anatolbricoham/bricohams-sdr/docs/esquemas/02_gpio_pi5.png

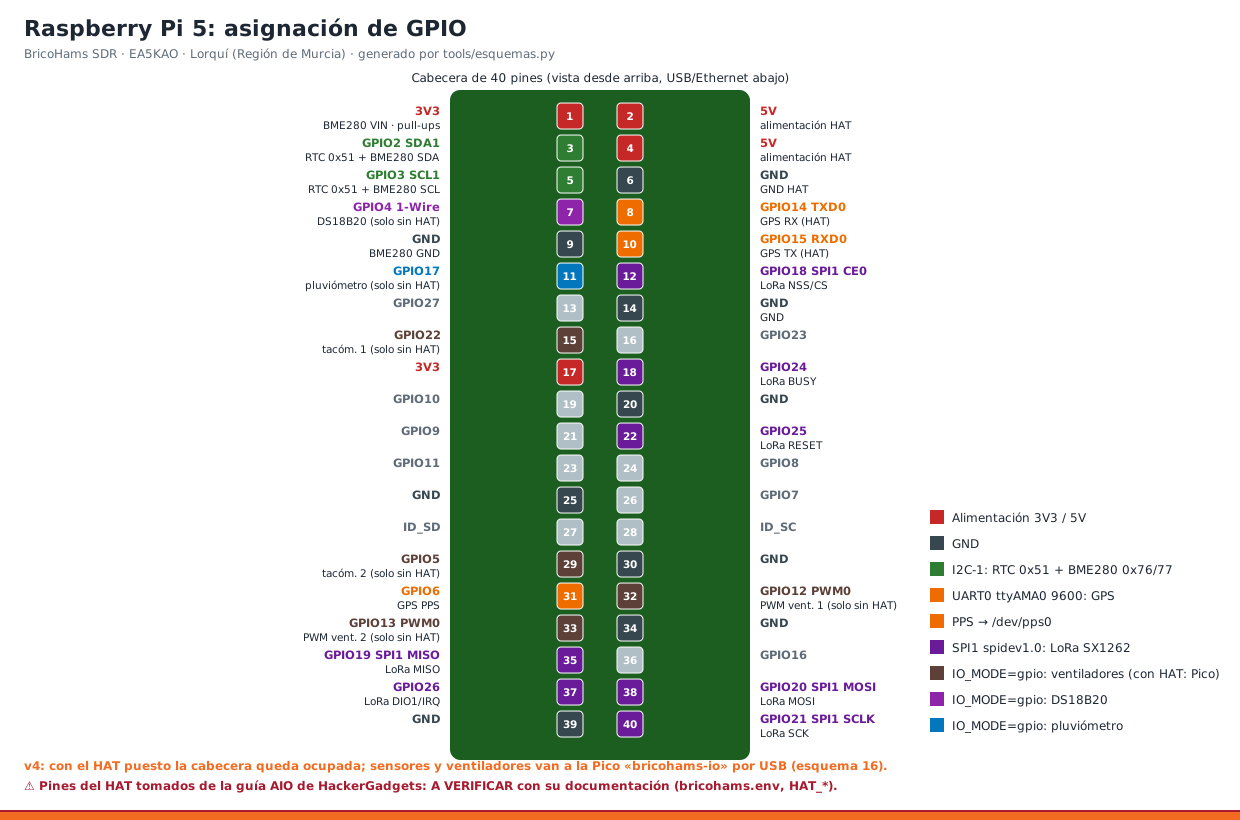
docs/esquemas/02_gpio_pi5.png
