anatolbricoham/bricohams-sdr/docs/esquemas/04_rf_antenas_alimentacion.png

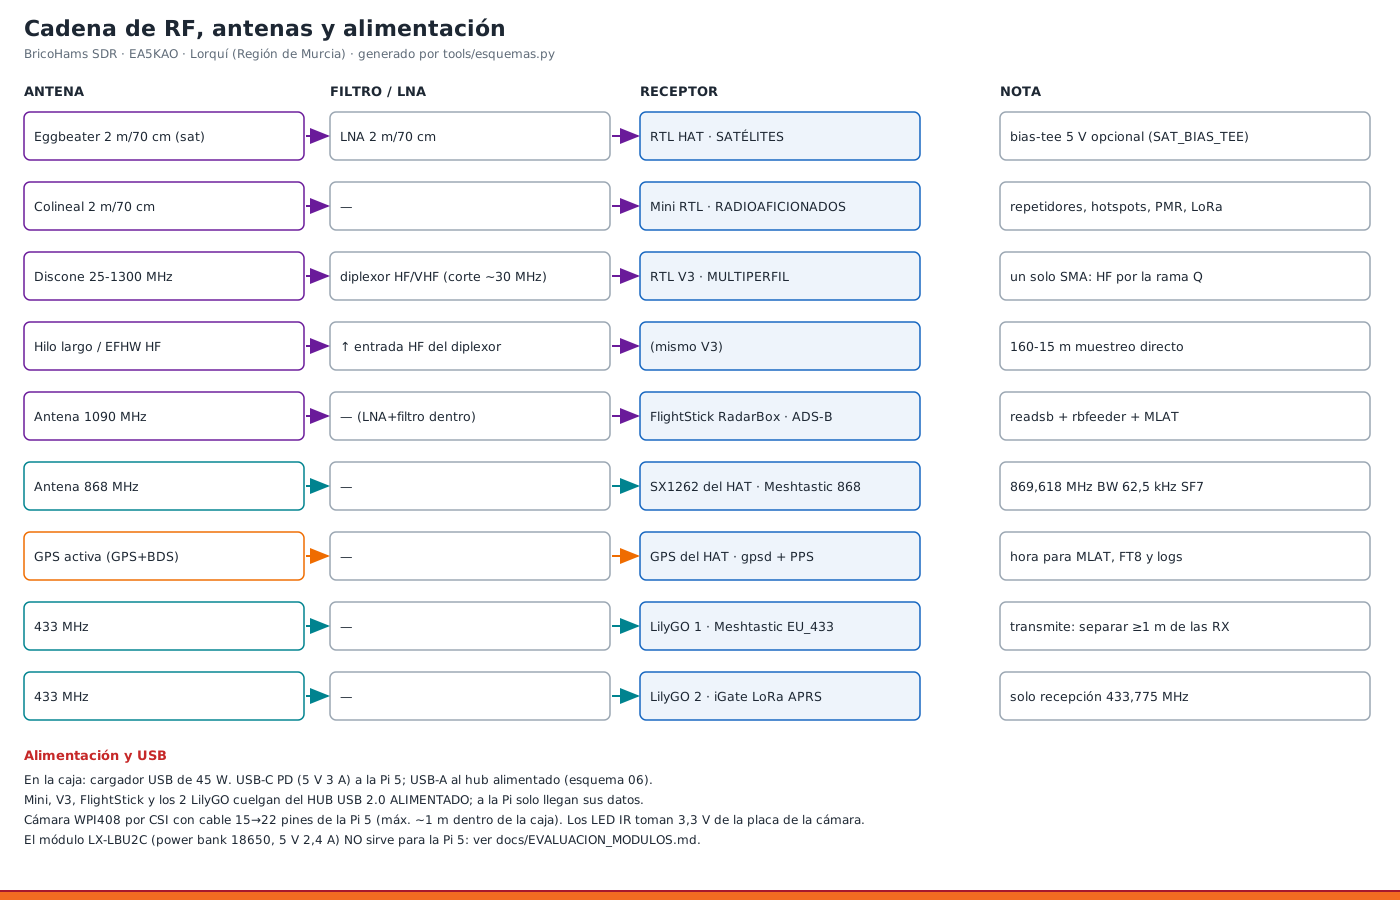
docs/esquemas/04_rf_antenas_alimentacion.png
