anatolbricoham/bricohams-sdr/docs/esquemas/05_red_puertos.png

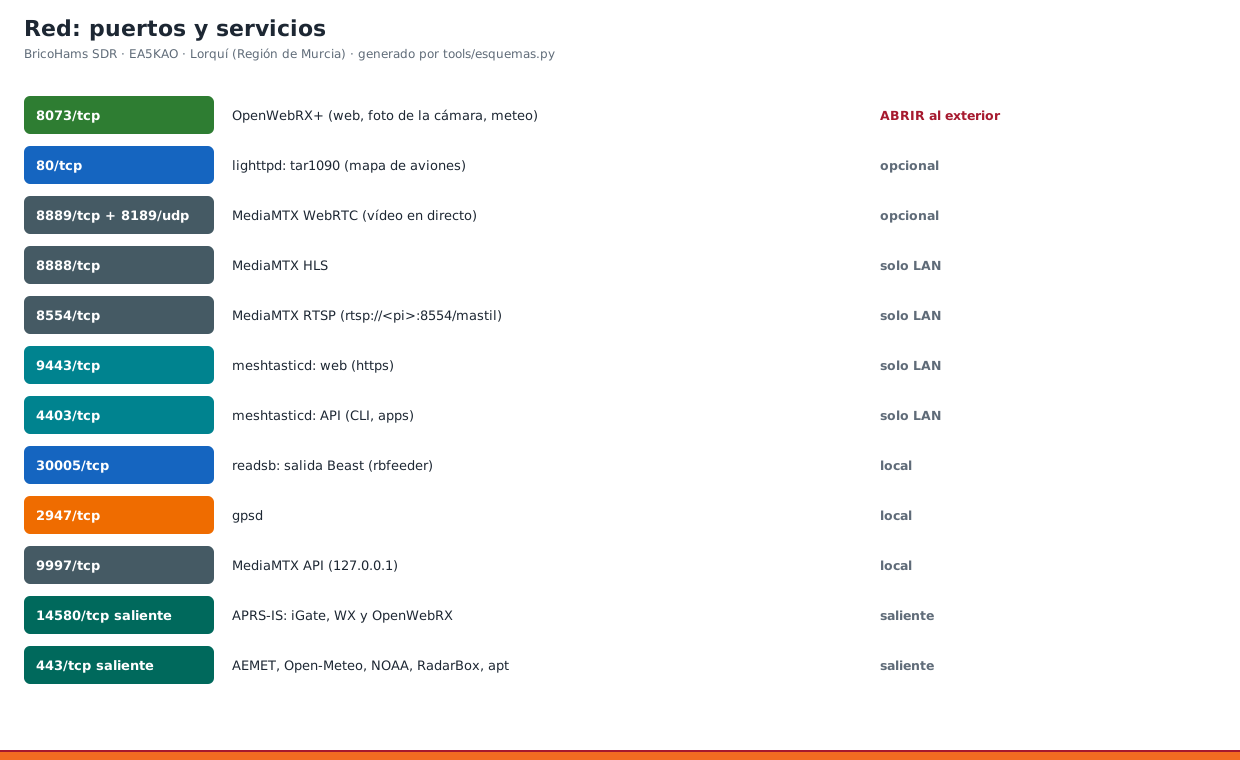
docs/esquemas/05_red_puertos.png
