anatolbricoham/bricohams-sdr/docs/esquemas/09_discones.png

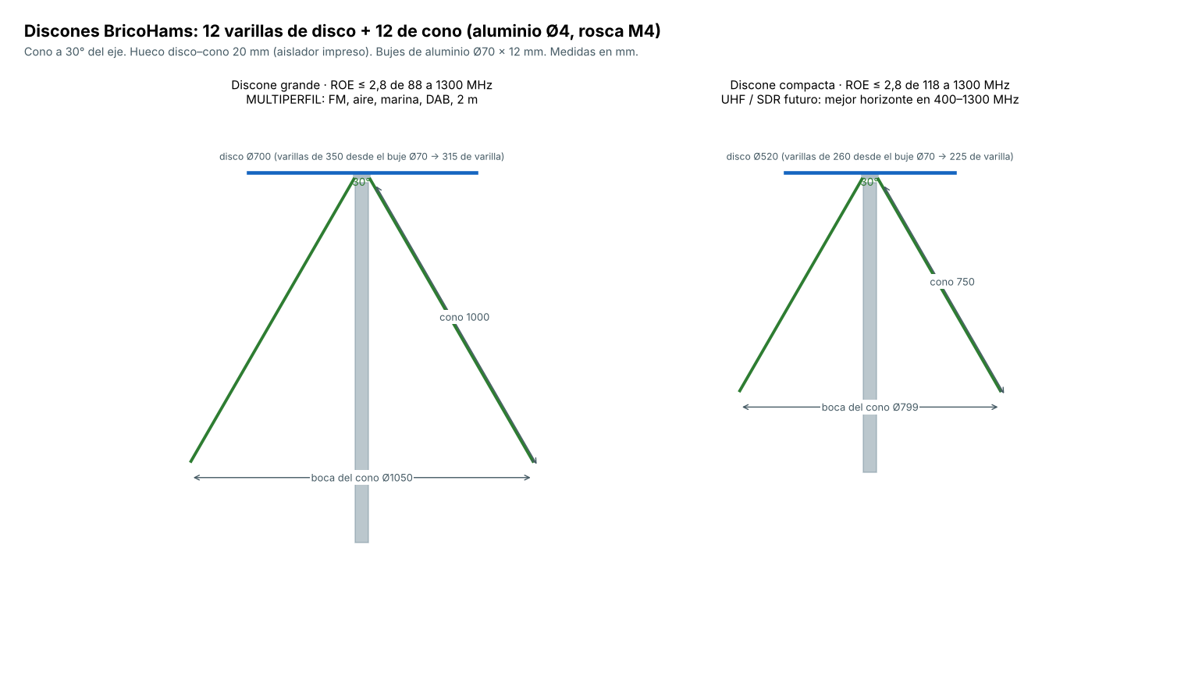
docs/esquemas/09_discones.png
