anatolbricoham/bricohams-sdr/docs/esquemas/12_cadena_rf.png

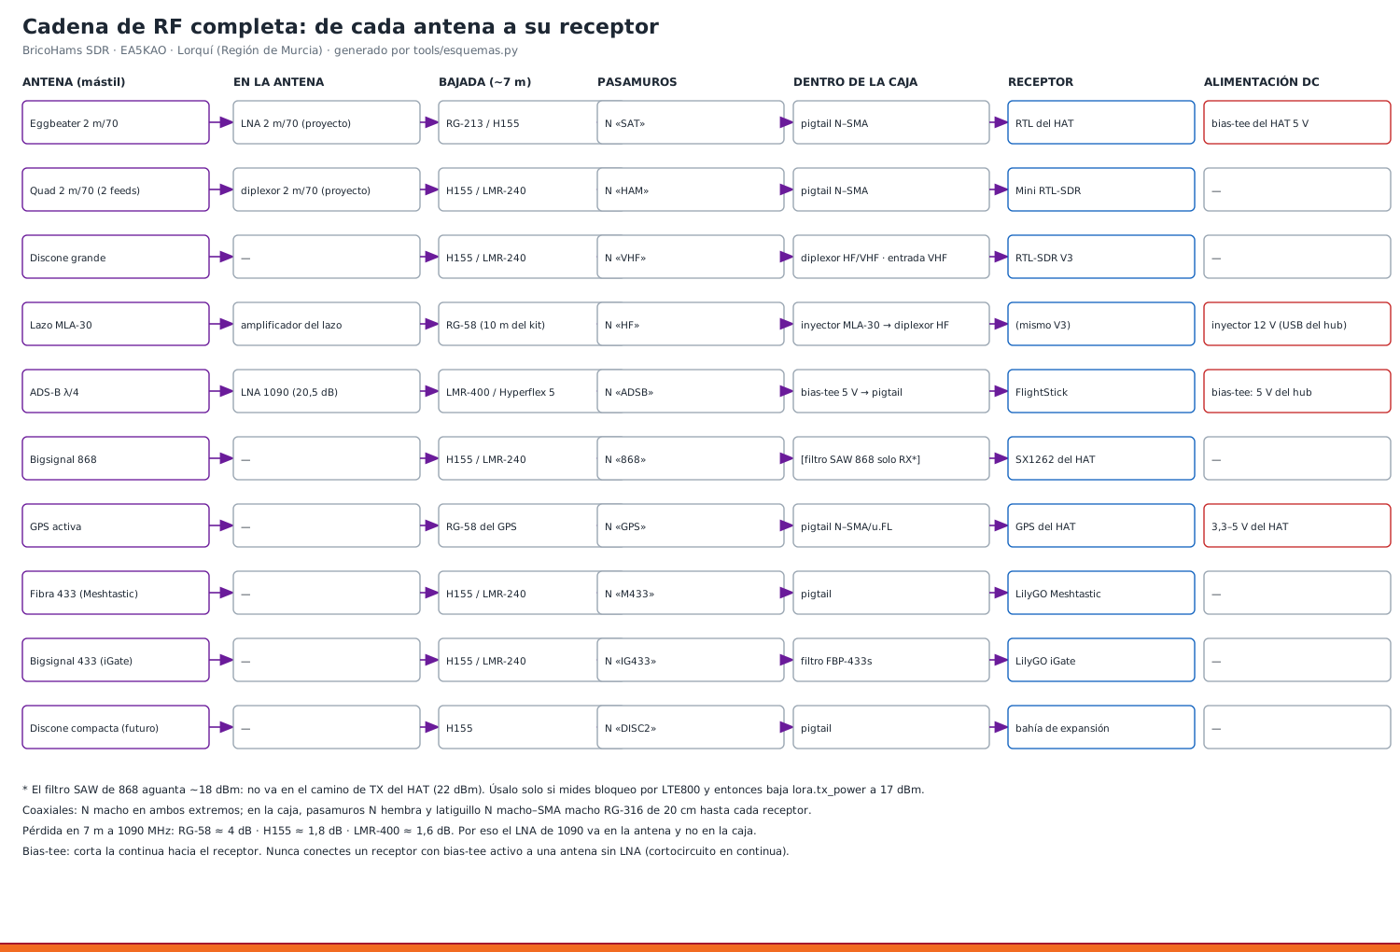
docs/esquemas/12_cadena_rf.png
