anatolbricoham/bricohams-sdr/docs/esquemas/17_filtros_lna.png

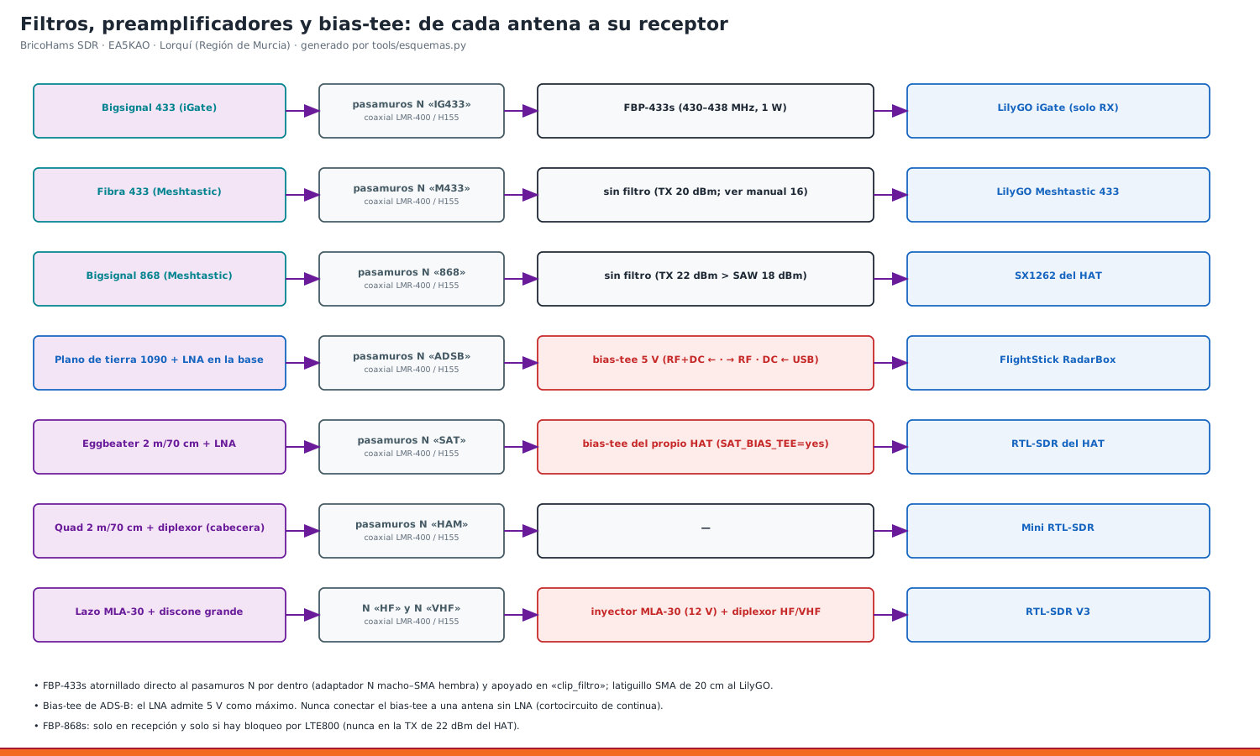
docs/esquemas/17_filtros_lna.png
