anatolbricoham/bricohams-sdr/docs/esquemas/20_audio_navegador.png

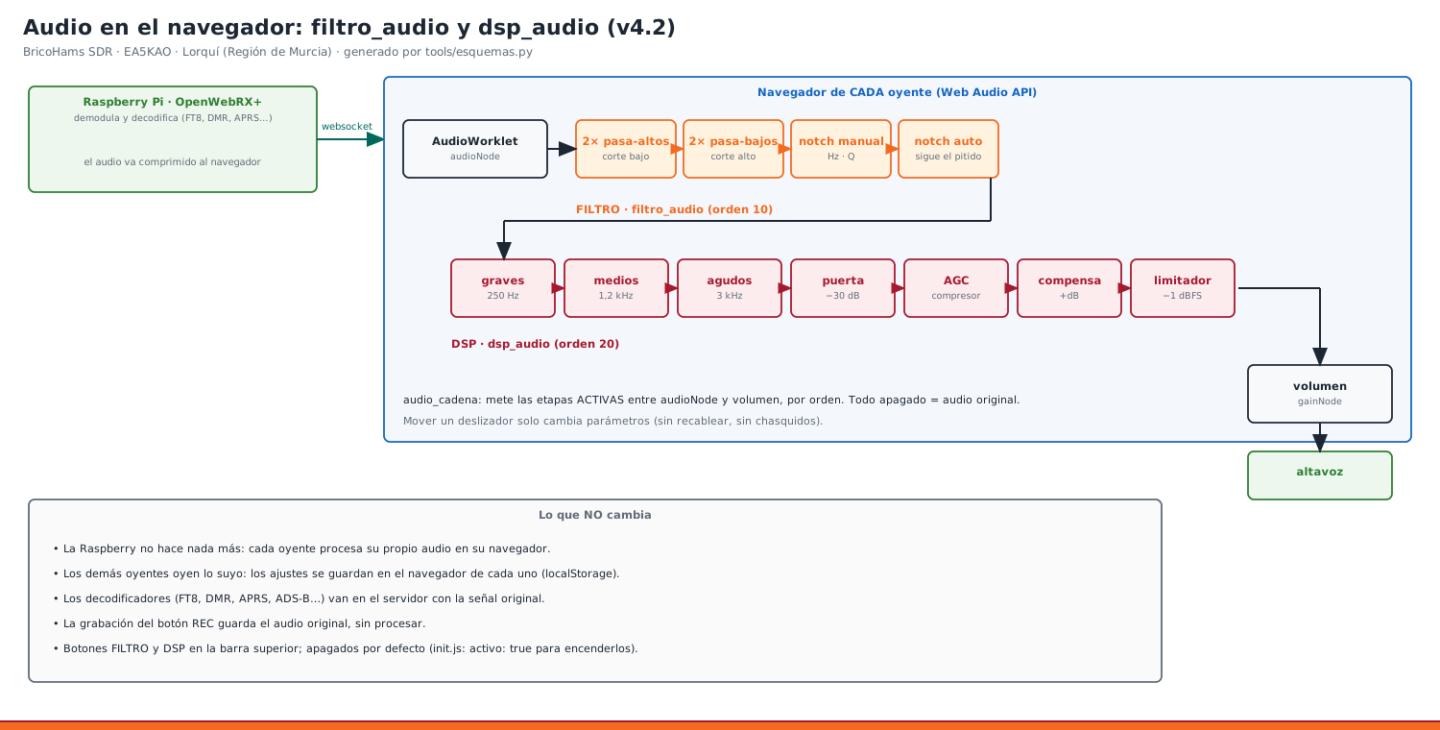
docs/esquemas/20_audio_navegador.png
