anatolbricoham/bricohams-sdr/docs/esquemas/22_zona_locator.png

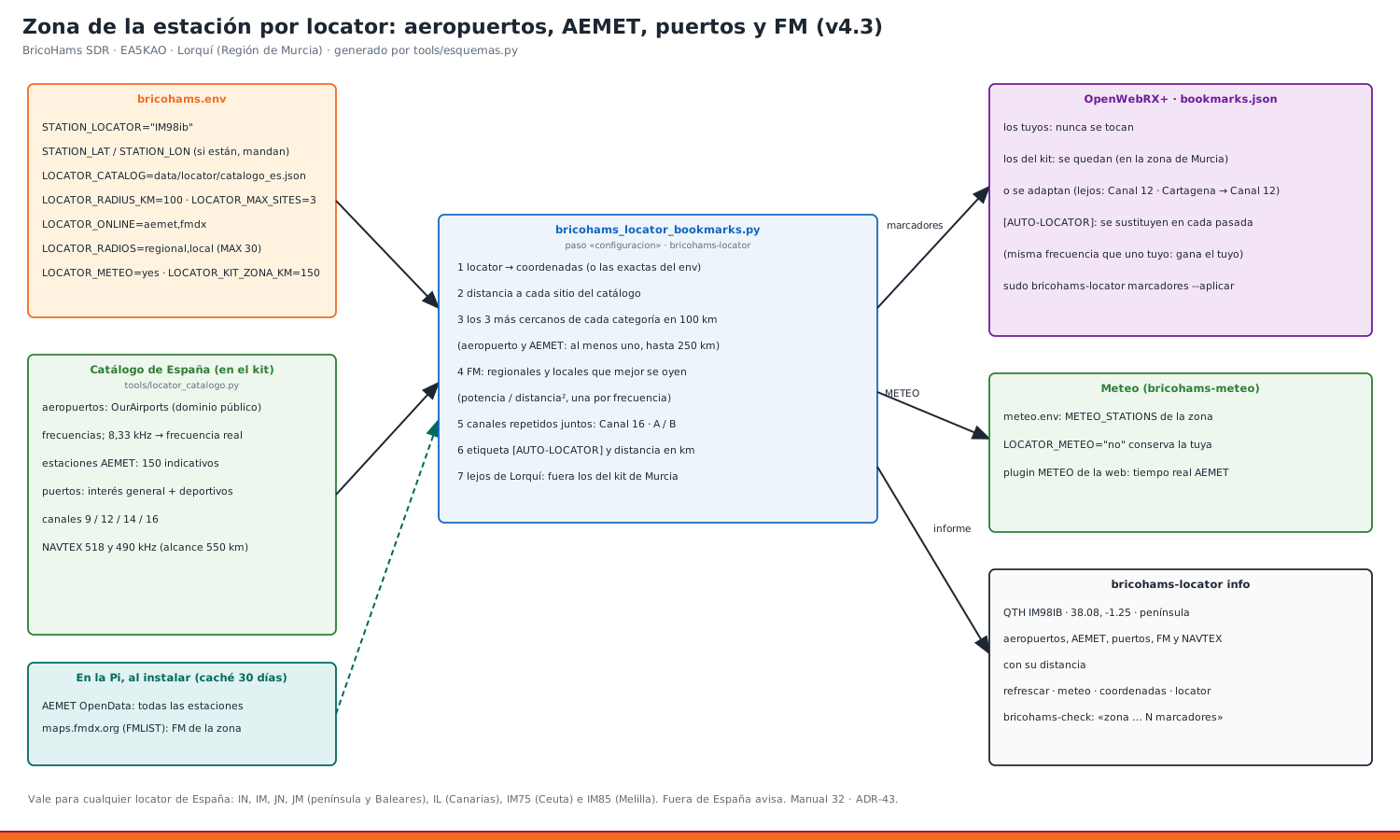
docs/esquemas/22_zona_locator.png
