anatolbricoham/bricohams-sdr/docs/esquemas/26_procedimiento_seguro.png

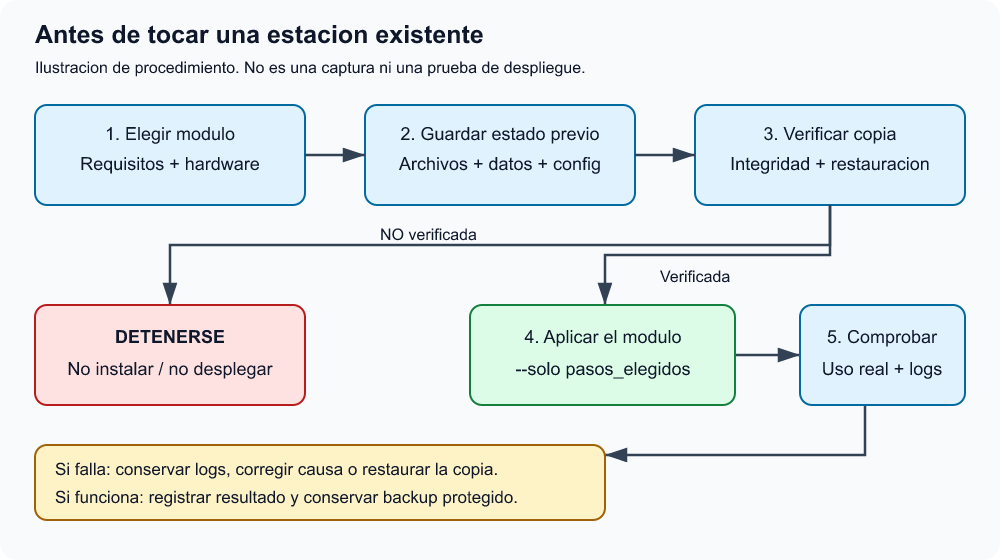
docs/esquemas/26_procedimiento_seguro.png
