anatolbricoham/bricohams-sdr/files/branding/receiver_top_photo_v3.png

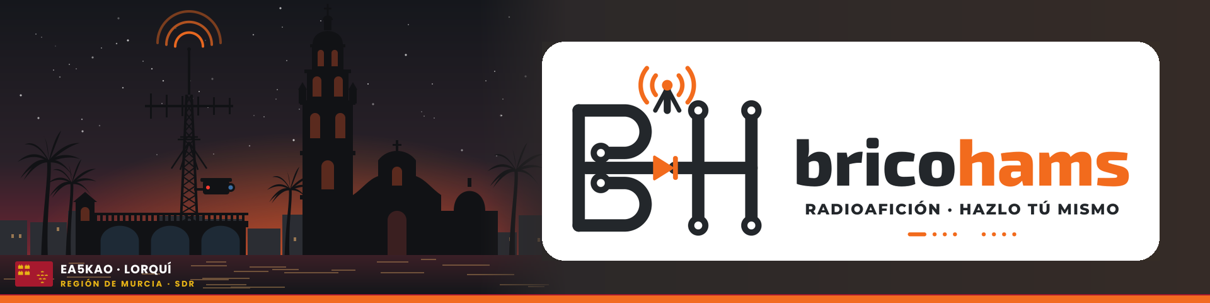
files/branding/receiver_top_photo_v3.png
