anatolbricoham/bricohams-sdr/files/htdocs/plugins/map/layer_qth_maidenhead/maidenhead.png

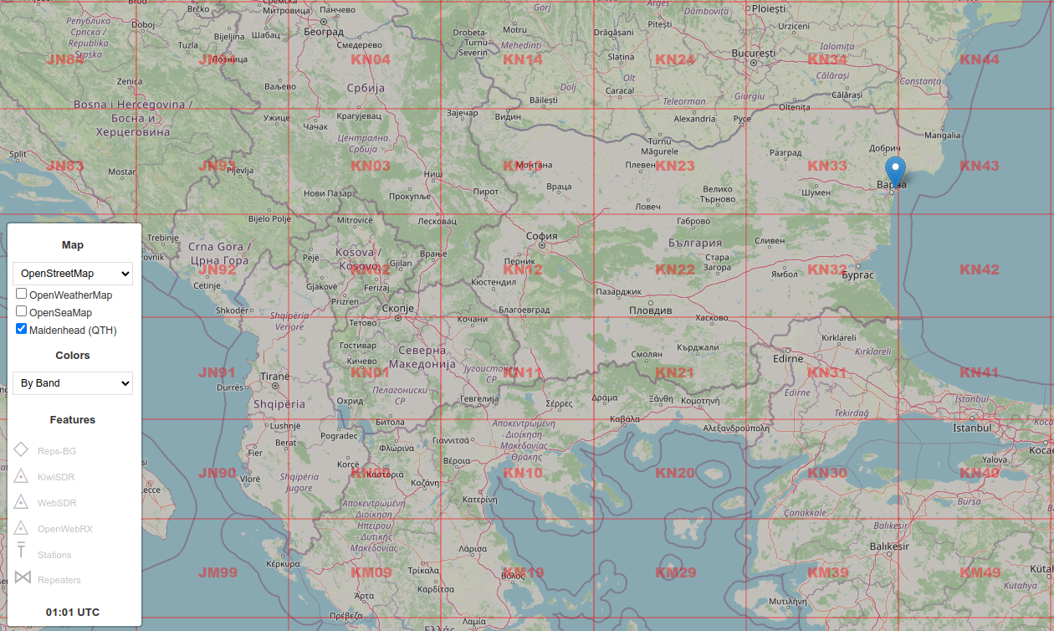
files/htdocs/plugins/map/layer_qth_maidenhead/maidenhead.png
