anatolbricoham/bricohams-sdr/files/htdocs/plugins/map/reduce_map_legend_sections/reduce_map_legend_sections.png

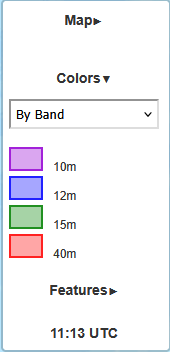
files/htdocs/plugins/map/reduce_map_legend_sections/reduce_map_legend_sections.png
