anatolbricoham/bricohams-sdr/files/htdocs/plugins/receiver/colorful_spectrum/colorful_spectrum.png

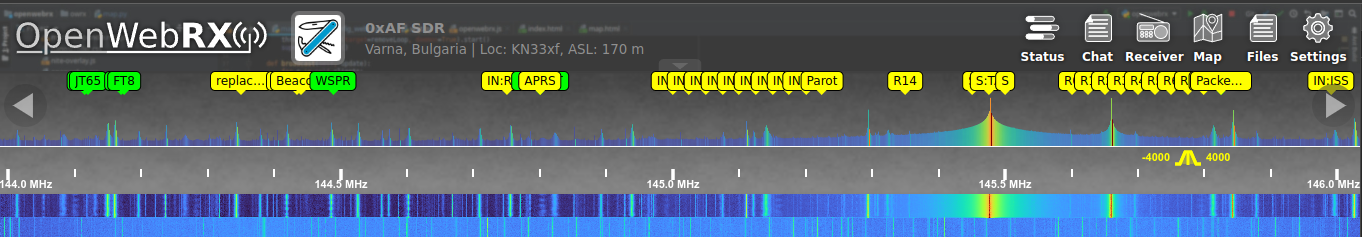
files/htdocs/plugins/receiver/colorful_spectrum/colorful_spectrum.png
