anatolbricoham/bricohams-sdr/files/htdocs/plugins/receiver/compact_analog_modes/compact_analog_modes.png

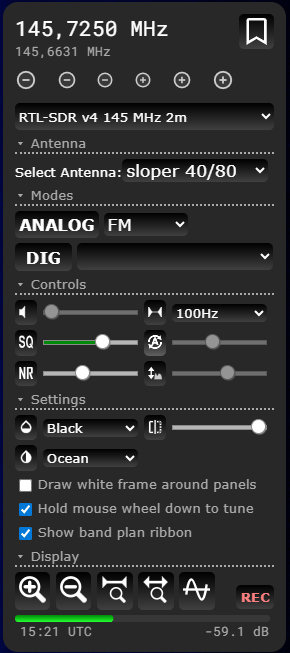
files/htdocs/plugins/receiver/compact_analog_modes/compact_analog_modes.png
