anatolbricoham/bricohams-sdr/files/htdocs/plugins/receiver/connect_notify/connect_notify.png

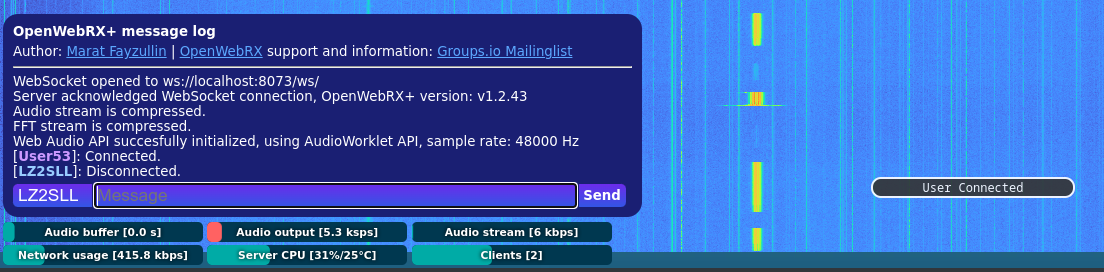
files/htdocs/plugins/receiver/connect_notify/connect_notify.png
