anatolbricoham/bricohams-sdr/files/htdocs/plugins/receiver/doppler/doppler1.png

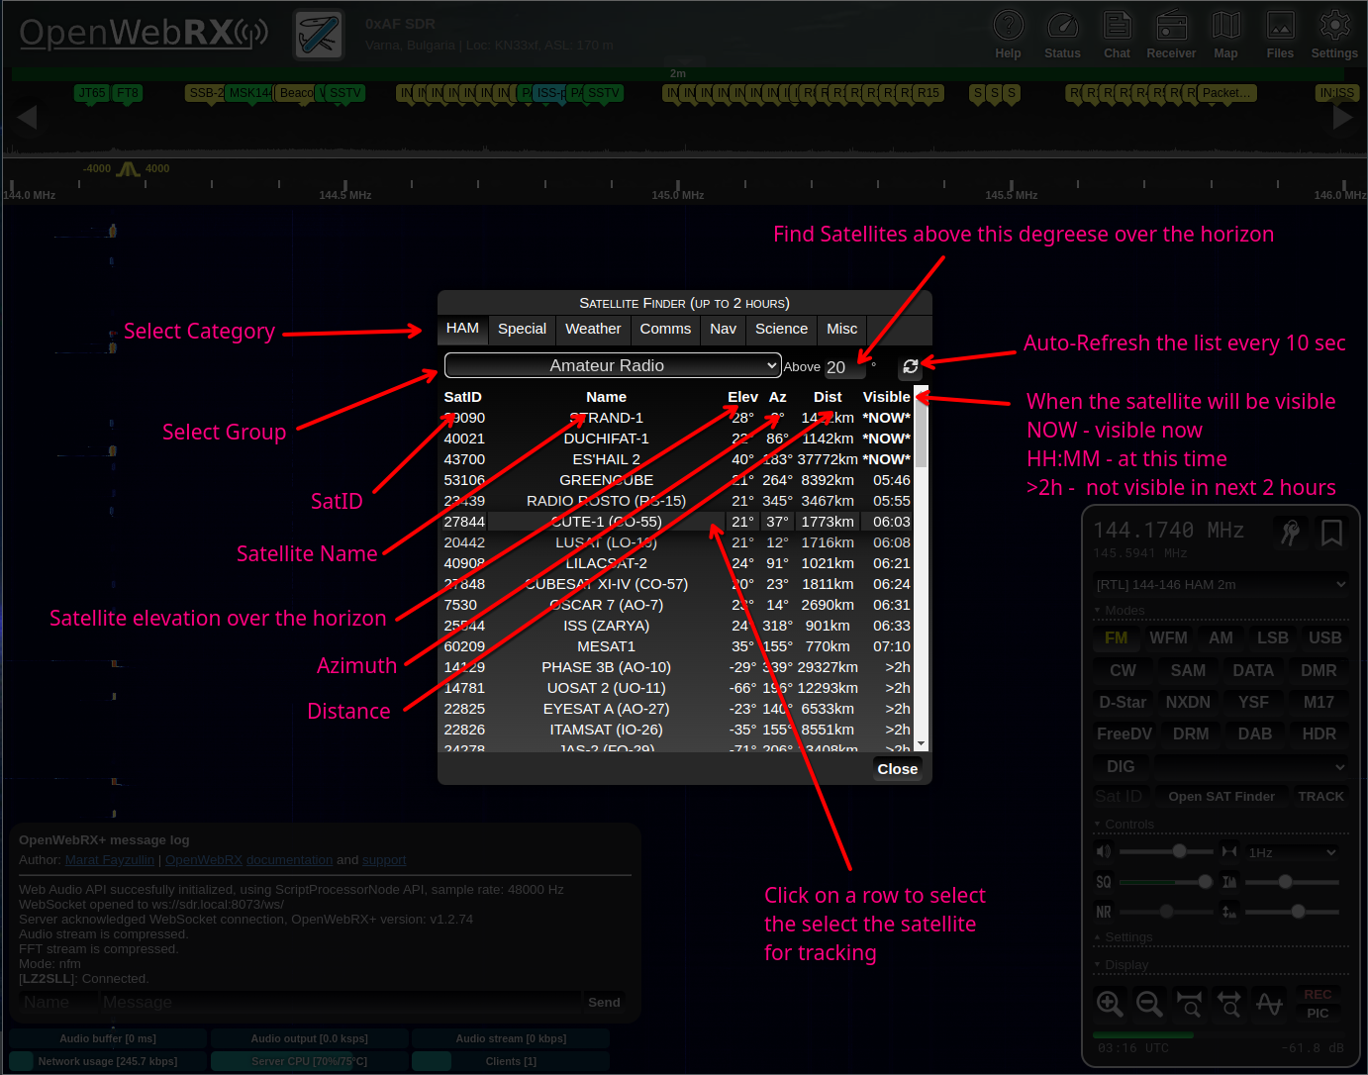
files/htdocs/plugins/receiver/doppler/doppler1.png
