anatolbricoham/bricohams-sdr/files/htdocs/plugins/receiver/doppler/doppler.png

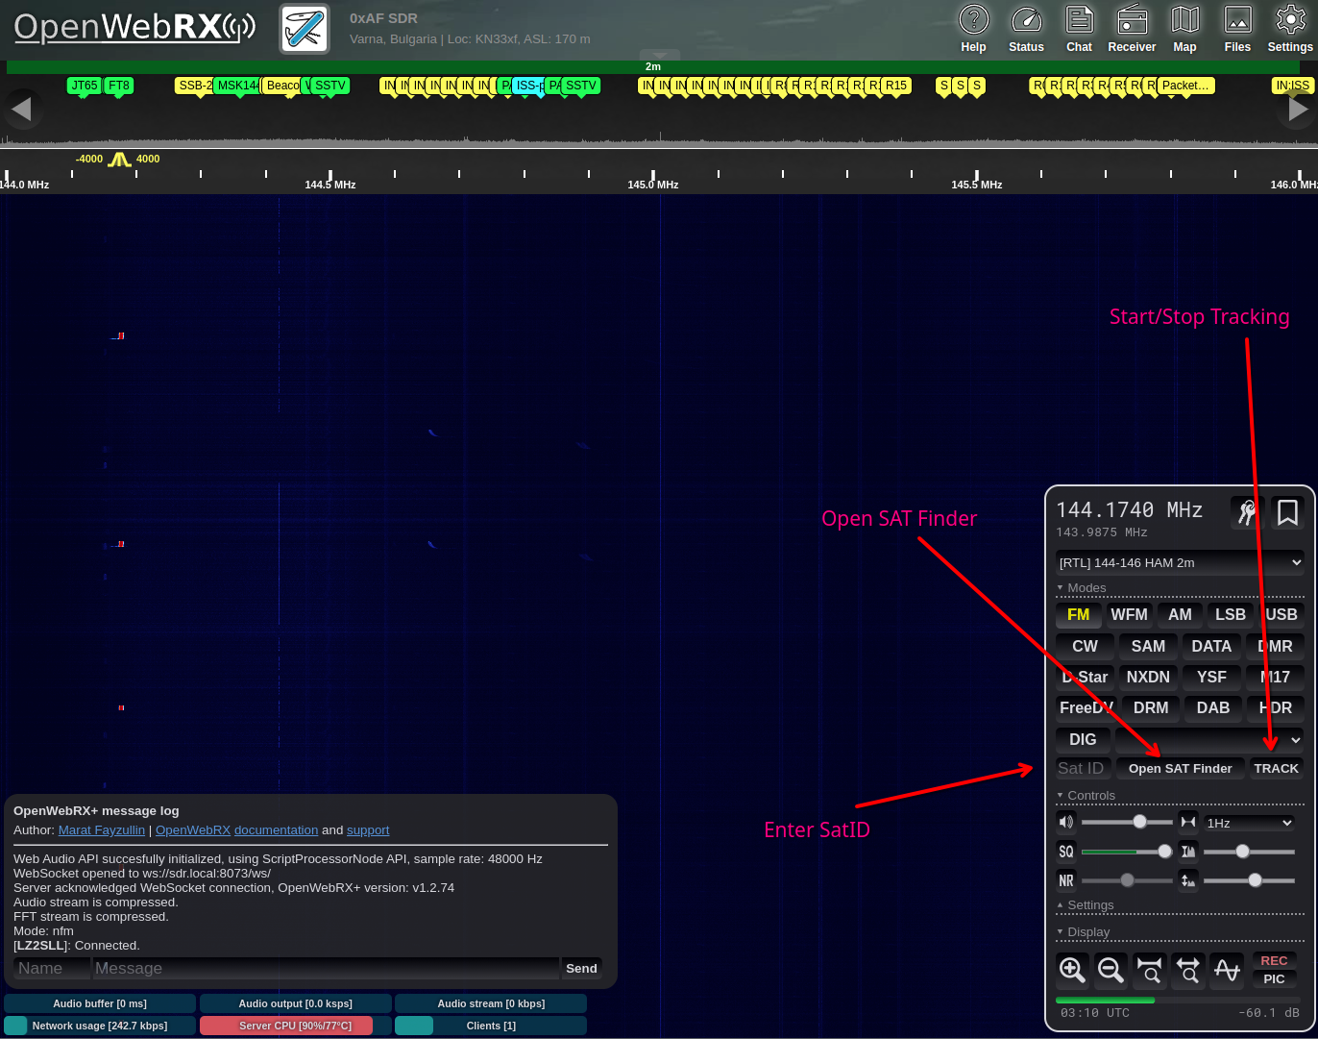
files/htdocs/plugins/receiver/doppler/doppler.png
