anatolbricoham/bricohams-sdr/files/htdocs/plugins/receiver/freq_scanner/freq_scanner.jpg

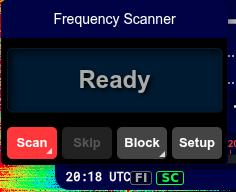
files/htdocs/plugins/receiver/freq_scanner/freq_scanner.jpg
