anatolbricoham/bricohams-sdr/files/htdocs/plugins/receiver/keyboard_shortcuts/shortcuts.png

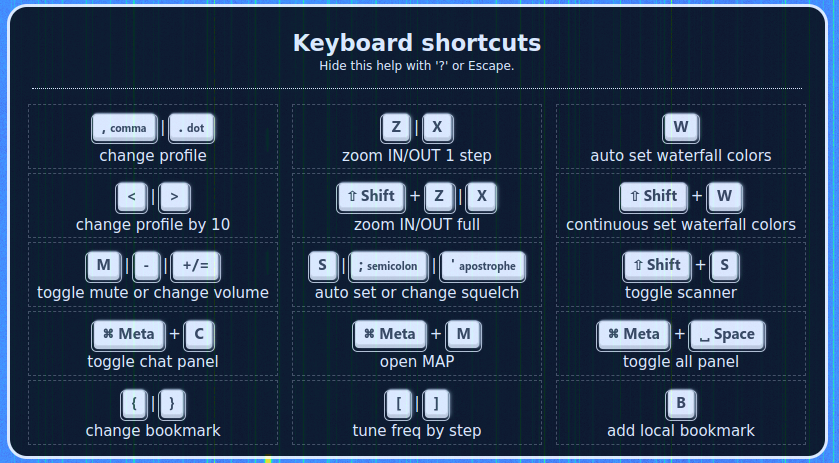
files/htdocs/plugins/receiver/keyboard_shortcuts/shortcuts.png
