anatolbricoham/bricohams-sdr/files/htdocs/plugins/receiver/magic_key/magic_key.png

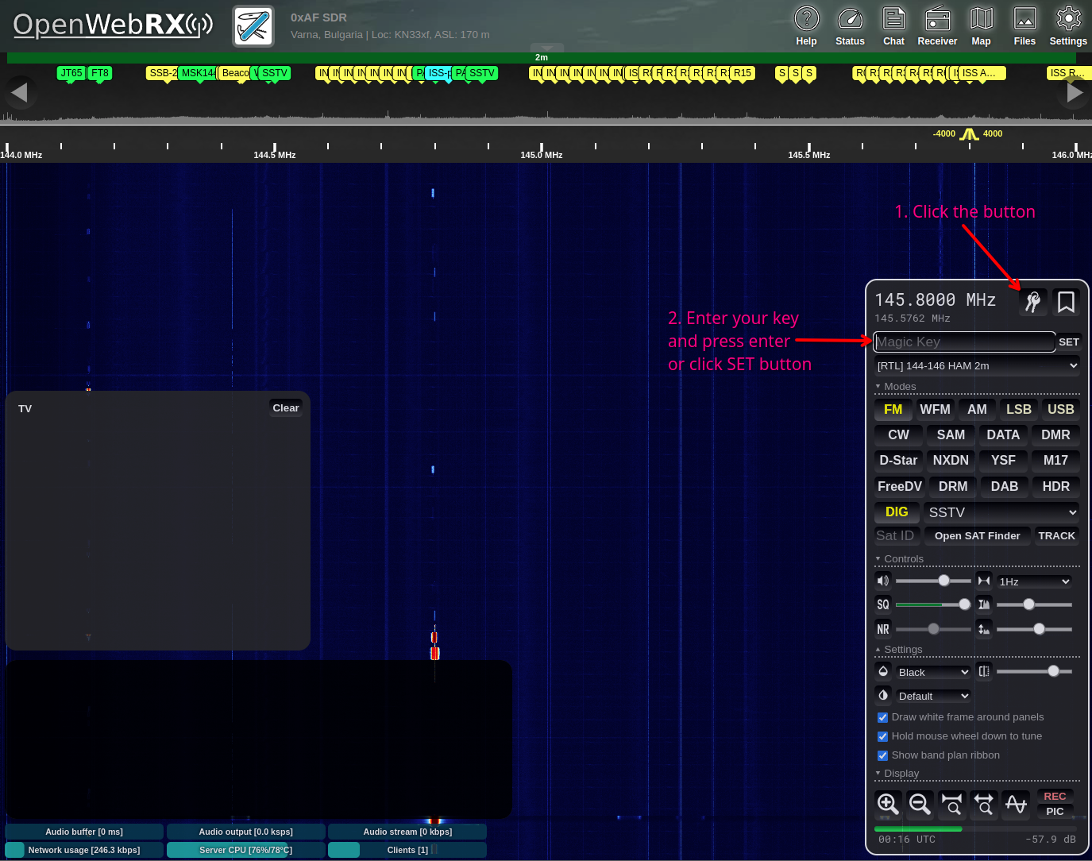
files/htdocs/plugins/receiver/magic_key/magic_key.png
