anatolbricoham/bricohams-sdr/files/htdocs/plugins/receiver/mouse_freq/mouse_freq.png

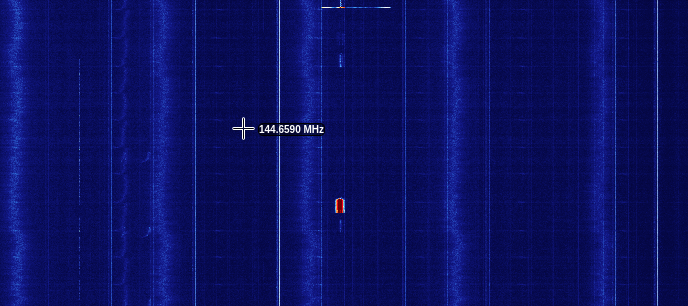
files/htdocs/plugins/receiver/mouse_freq/mouse_freq.png
