anatolbricoham/bricohams-sdr/files/htdocs/plugins/receiver/screen_reader/screen_reader.png

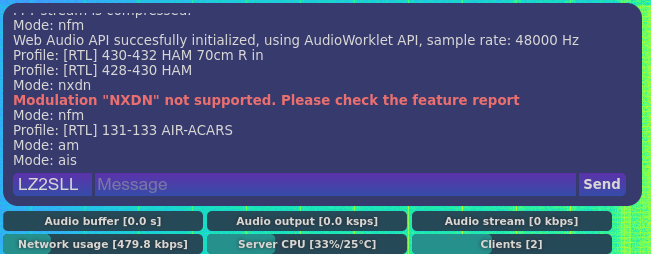
files/htdocs/plugins/receiver/screen_reader/screen_reader.png
