anatolbricoham/bricohams-sdr/files/htdocs/plugins/receiver/screenshot/screenshot.png

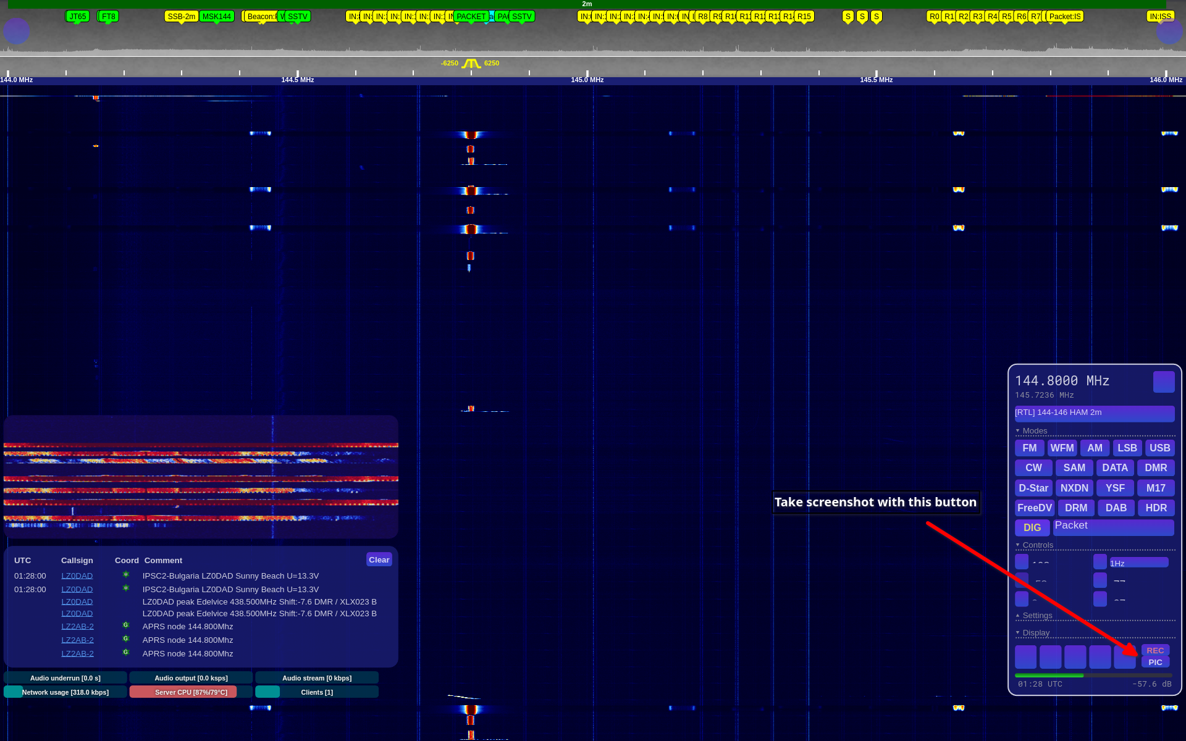
files/htdocs/plugins/receiver/screenshot/screenshot.png
