anatolbricoham/bricohams-sdr/files/htdocs/plugins/receiver/thumbtune/thumbtune.jpg

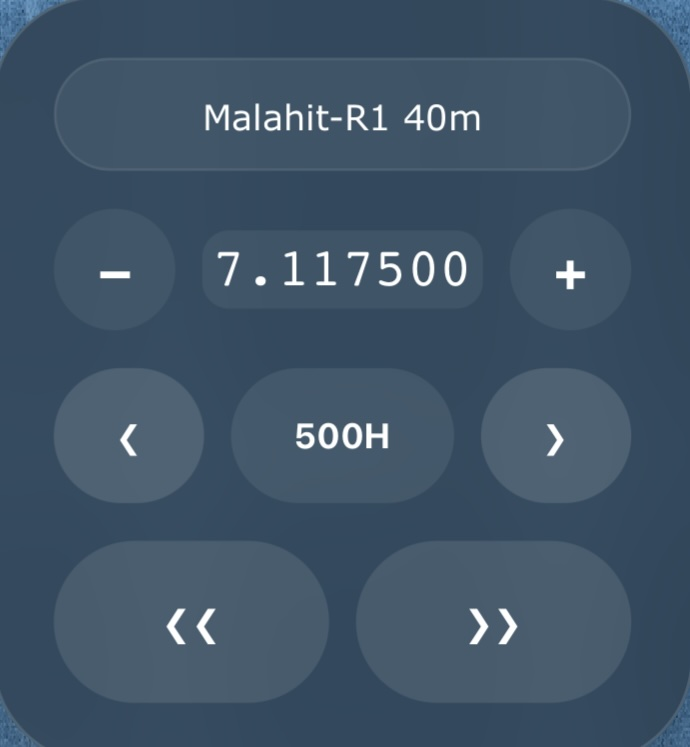
files/htdocs/plugins/receiver/thumbtune/thumbtune.jpg
