anatolbricoham/bricohams-sdr/files/htdocs/plugins/receiver/toggle_scannable/toggle_scannable.png

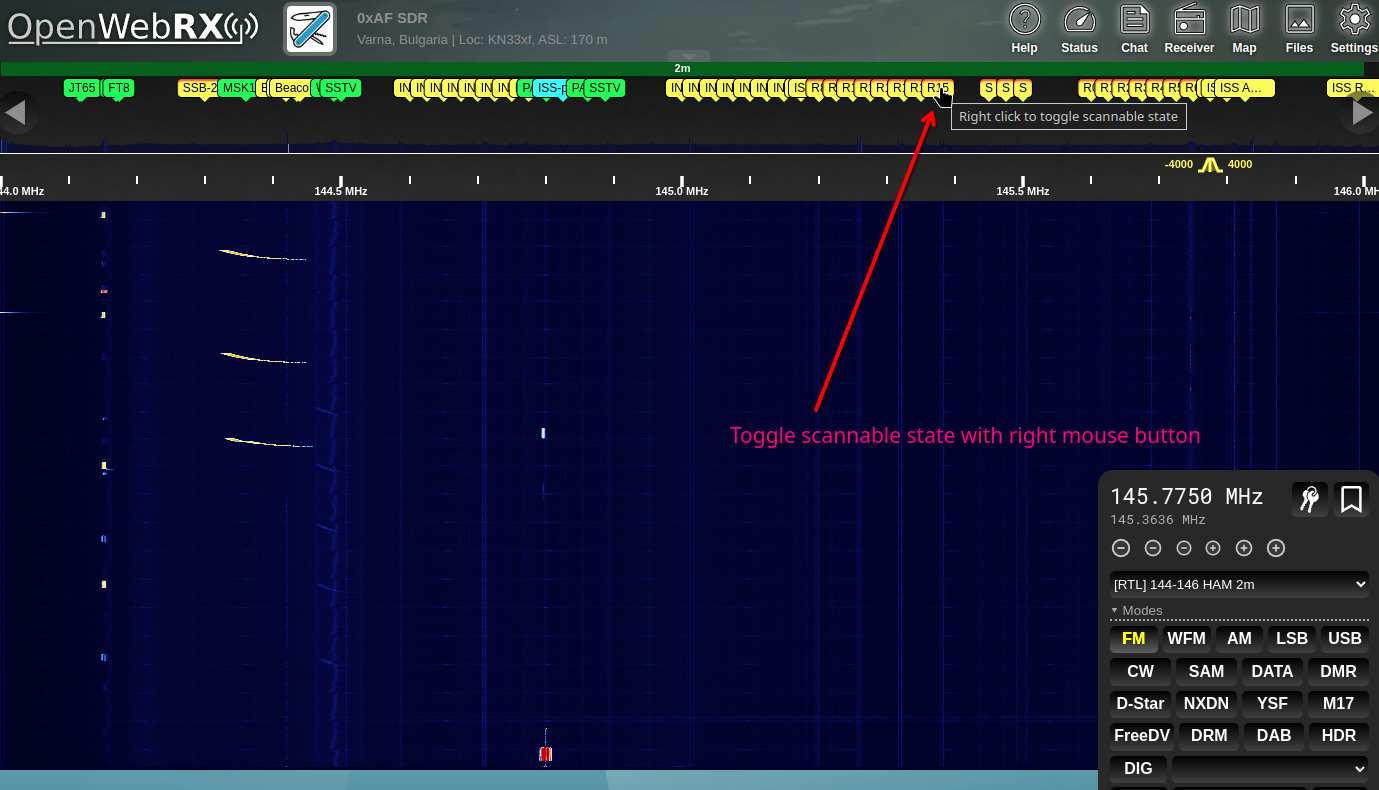
files/htdocs/plugins/receiver/toggle_scannable/toggle_scannable.png
