anatolbricoham/bricohams-sdr/files/htdocs/plugins/receiver/uikit/uikit.png

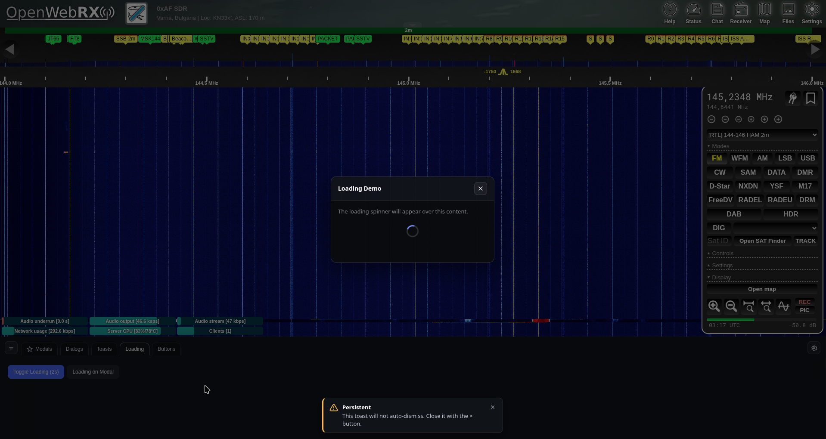
files/htdocs/plugins/receiver/uikit/uikit.png
