anatolbricoham/bricohams-sdr/hardware/anclajes/stl/cruceta_mastil_brazo_cuerpo.stl

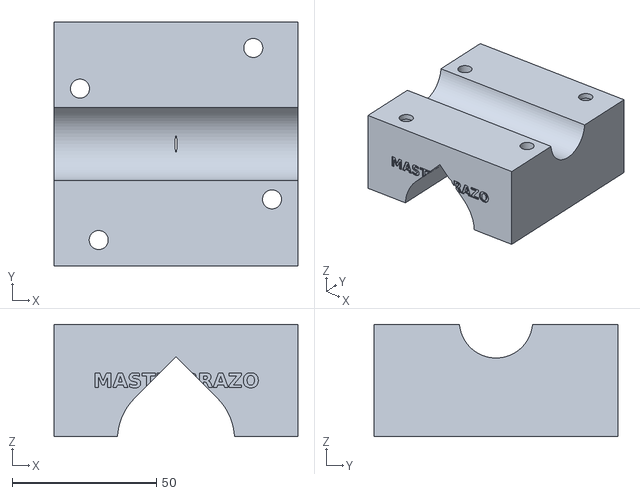
[picture p38: CAD file, 2026-10-16]
hardware/anclajes/stl/cruceta_mastil_brazo_cuerpo.stl
84.6 x 84.6 x 39.0
