anatolbricoham/bricohams-sdr/hardware/caja_v3/stl/potencia_junta_tapa.stl

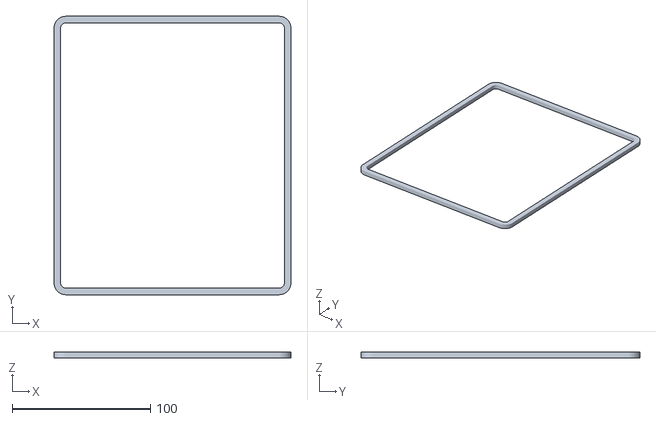
[picture p40: CAD file, 2026-10-17]
hardware/caja_v3/stl/potencia_junta_tapa.stl
171.2 x 201.2 x 4.00
