anatolbricoham/bricohams-sdr/hardware/anclajes/stl/adsb_tapa_tubo.stl

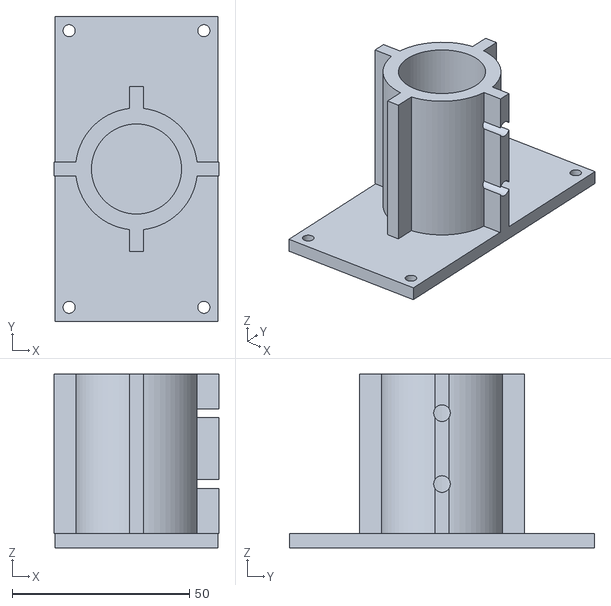
[picture p41: CAD file, 2026-10-16]
hardware/anclajes/stl/adsb_tapa_tubo.stl
46.4 x 86.0 x 49.0
