anatolbricoham/bricohams-sdr/hardware/antenas/stl/discone_capuchon.stl

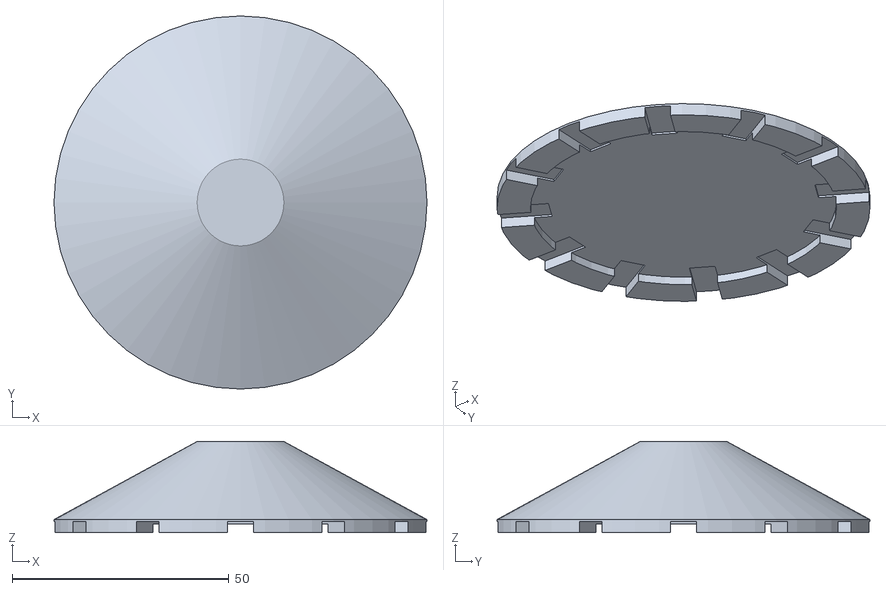
[picture p42: CAD file, 2026-10-16]
hardware/antenas/stl/discone_capuchon.stl
86.0 x 86.0 x 21.0
