anatolbricoham/bricohams-sdr/hardware/anclajes/stl/cruceta_brazo_fibra_tapa_brazo.stl

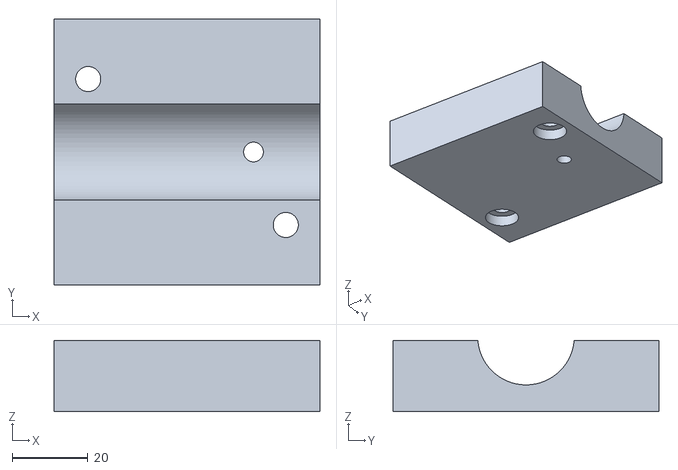
[picture p44: CAD file, 2026-10-16]
hardware/anclajes/stl/cruceta_brazo_fibra_tapa_brazo.stl
70.0 x 70.0 x 18.7
