anatolbricoham/bricohams-sdr/hardware/caja_v3/stl/electronica_tejadillo.stl

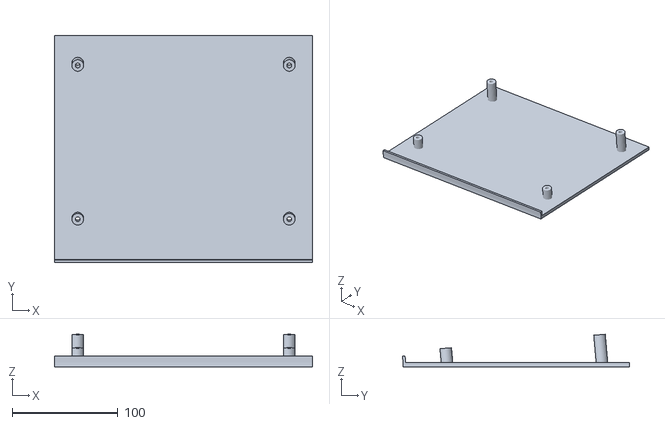
[picture p46: CAD file, 2026-10-17]
hardware/caja_v3/stl/electronica_tejadillo.stl
244.0 x 214.7 x 30.8
