anatolbricoham/bricohams-sdr/hardware/anclajes/stl/cruceta_mastil_brazo_tapa_mastil.stl

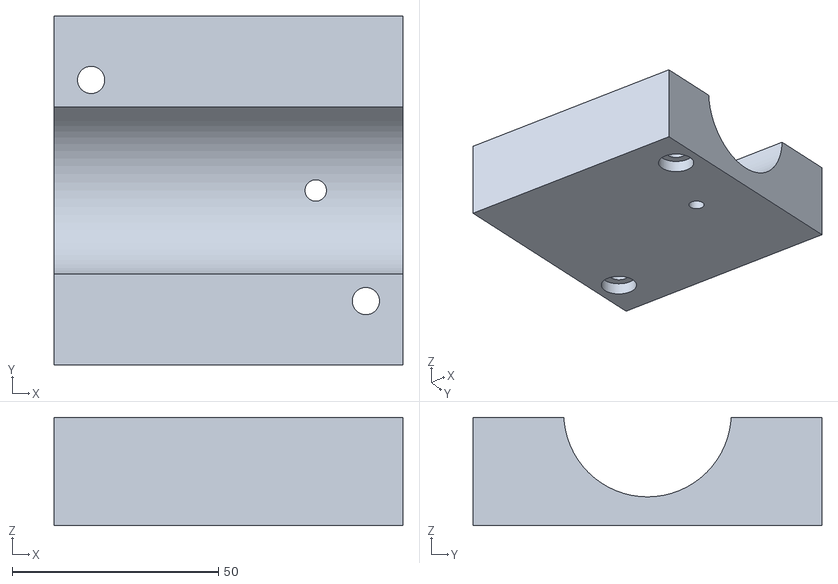
[picture p47: CAD file, 2026-10-16]
hardware/anclajes/stl/cruceta_mastil_brazo_tapa_mastil.stl
84.6 x 84.6 x 26.3
