anatolbricoham/bricohams-sdr/hardware/caja_v3/stl/sai_soporte_mastil.stl

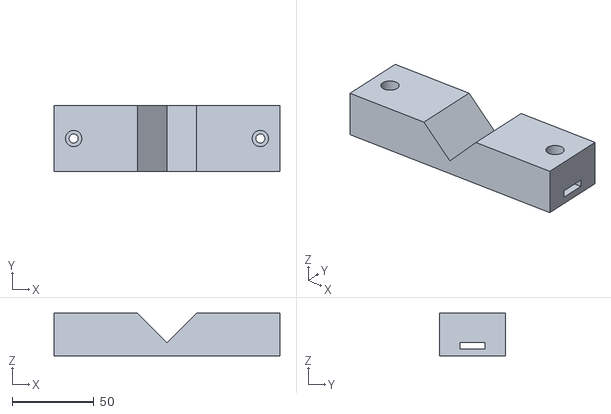
[picture p49: CAD file, 2026-10-17]
hardware/caja_v3/stl/sai_soporte_mastil.stl
138.0 x 40.0 x 26.0
