anatolbricoham/bricohams-sdr/hardware/anclajes/stl/cruceta_brazo_tubo_cuerpo.stl

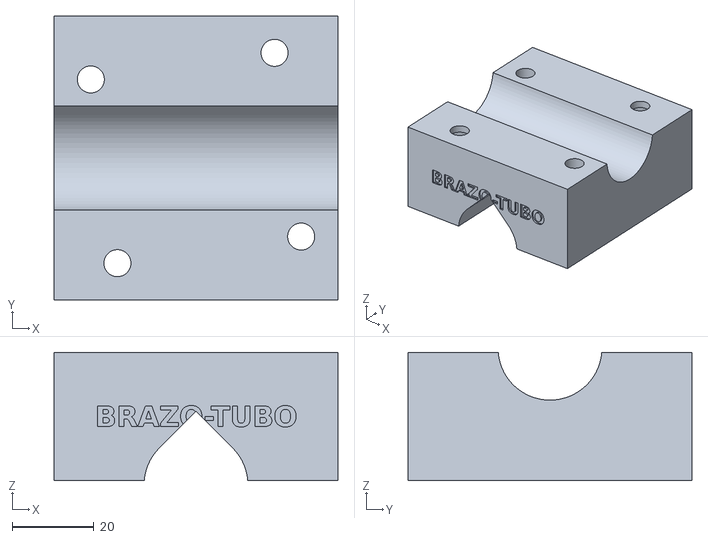
[picture p50: CAD file, 2026-10-16]
hardware/anclajes/stl/cruceta_brazo_tubo_cuerpo.stl
69.4 x 69.4 x 31.4
