anatolbricoham/bricohams-sdr/hardware/caja_v3/stl/sai_placa_rejilla.stl

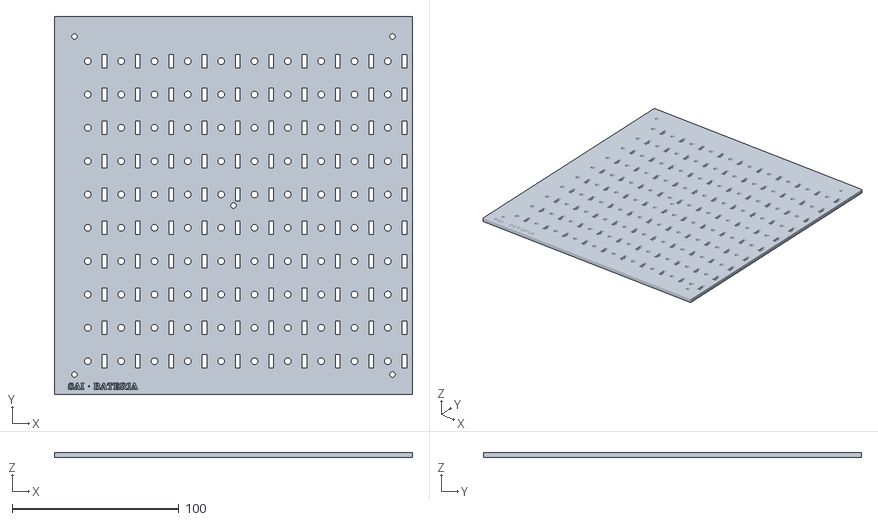
[picture p52: CAD file, 2026-10-17]
hardware/caja_v3/stl/sai_placa_rejilla.stl
214.8 x 226.8 x 3.20
