anatolbricoham/bricohams-sdr/hardware/anclajes/stl/sensor_viento_brida.stl

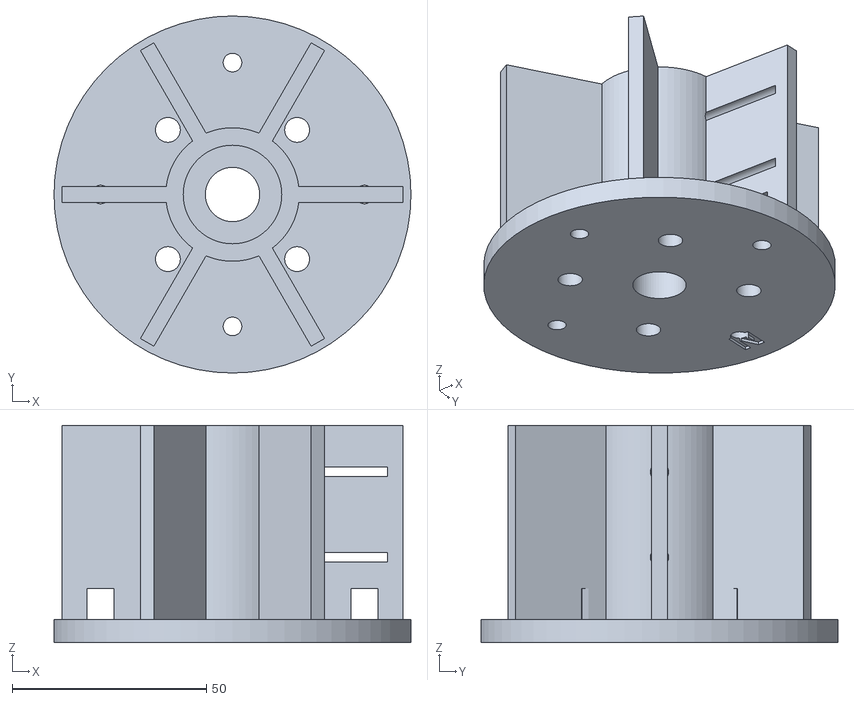
[picture p53: CAD file, 2026-10-16]
hardware/anclajes/stl/sensor_viento_brida.stl
92.0 x 92.0 x 56.0
