anatolbricoham/bricohams-sdr/hardware/antenas/stl/separador_coax.stl

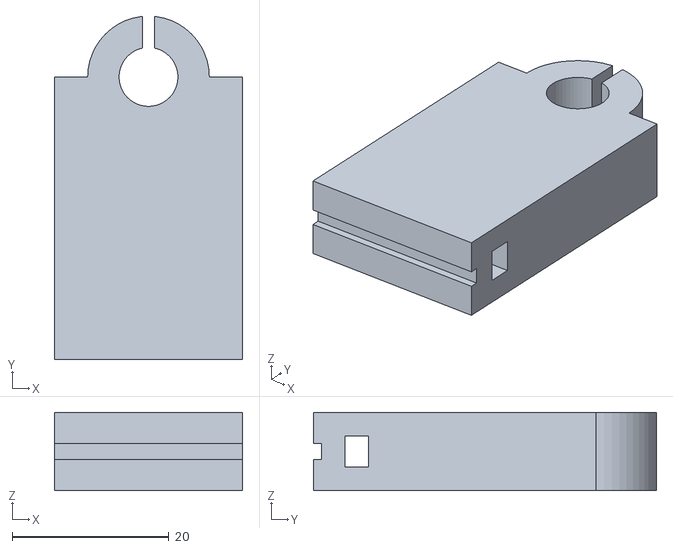
[picture p54: CAD file, 2026-10-16]
hardware/antenas/stl/separador_coax.stl
24.0 x 43.7 x 10.0
