anatolbricoham/bricohams-sdr/hardware/caja_v3/stl/potencia_soporte_schuko.stl

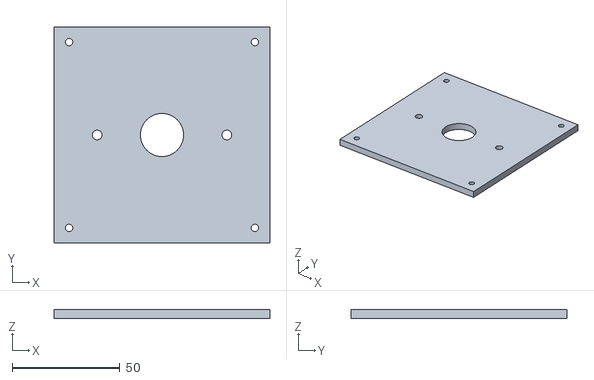
[picture p55: CAD file, 2026-10-17]
hardware/caja_v3/stl/potencia_soporte_schuko.stl
100.0 x 100.0 x 4.00
