anatolbricoham/bricohams-sdr/hardware/anclajes/stl/cruceta_brazo_fibra_cuerpo.stl

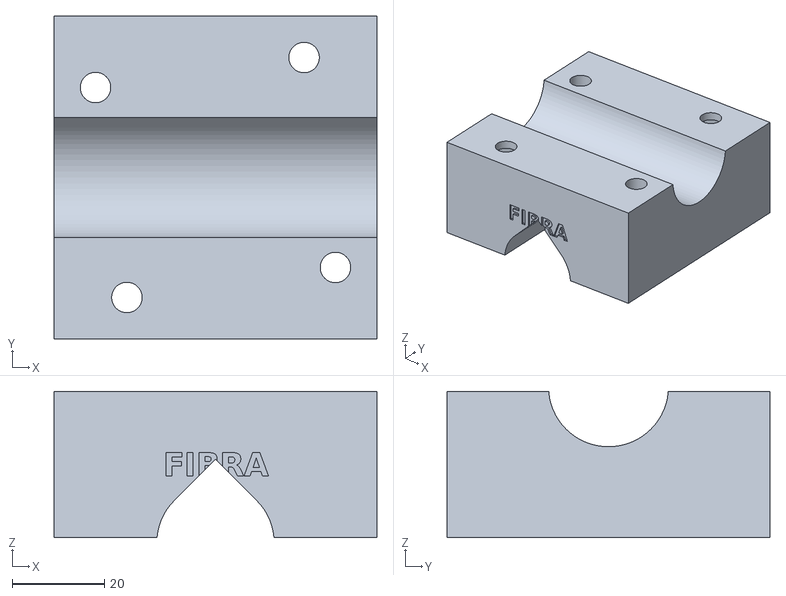
[picture p56: CAD file, 2026-10-16]
hardware/anclajes/stl/cruceta_brazo_fibra_cuerpo.stl
70.0 x 70.0 x 31.7
