anatolbricoham/bricohams-sdr/hardware/caja_v3/stl/electronica_tapa.stl

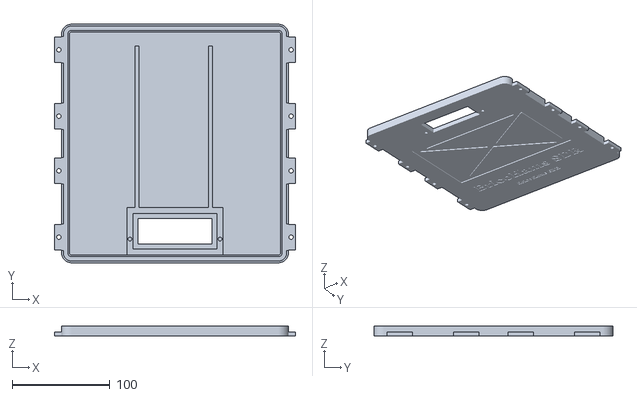
[picture p58: CAD file, 2026-10-17]
hardware/caja_v3/stl/electronica_tapa.stl
247.0 x 244.6 x 10.4
