anatolbricoham/bricohams-sdr/hardware/antenas/stl/discone_plantilla_cono.stl

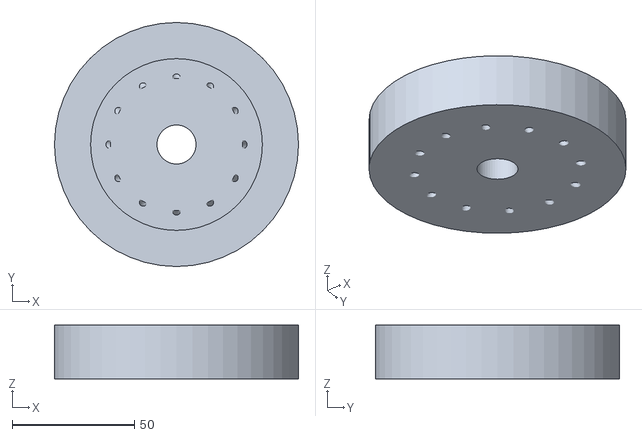
[picture p60: CAD file, 2026-10-16]
hardware/antenas/stl/discone_plantilla_cono.stl
100.0 x 100.0 x 22.0
