anatolbricoham/bricohams-sdr/hardware/antenas/stl/funda_n.stl

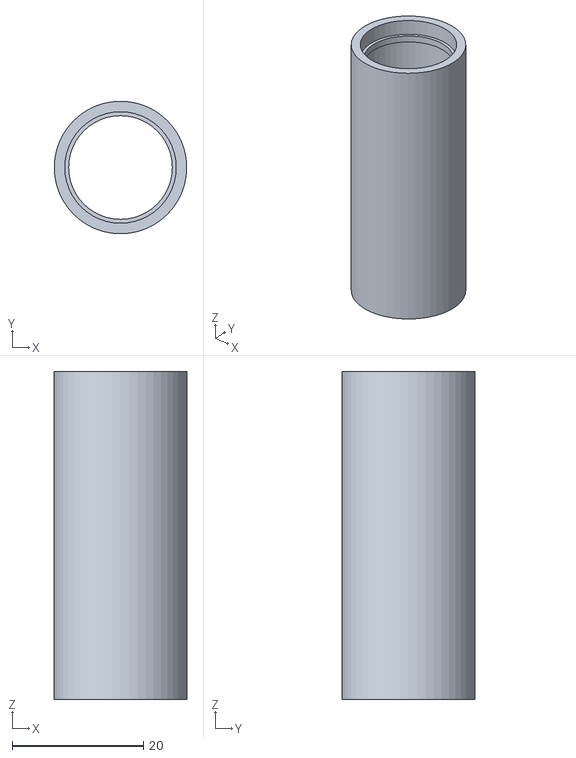
[picture p62: CAD file, 2026-10-16]
hardware/antenas/stl/funda_n.stl
20.2 x 20.2 x 50.0
