anatolbricoham/bricohams-sdr/hardware/caja_v3/stl/electronica_tapon_pg.stl

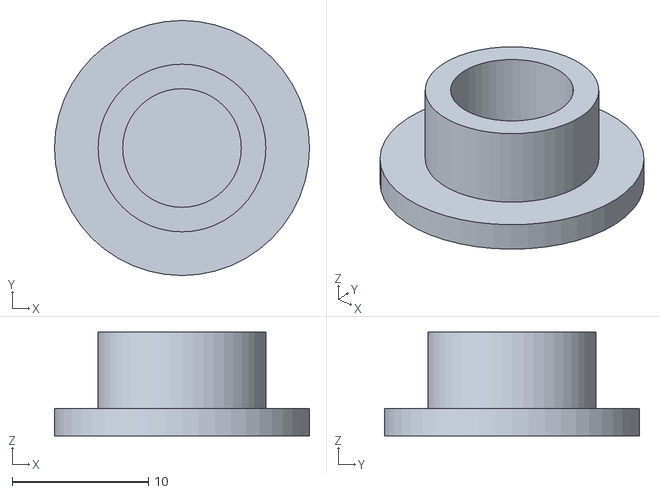
[picture p63: CAD file, 2026-10-17]
hardware/caja_v3/stl/electronica_tapon_pg.stl
18.7 x 18.7 x 7.60
