anatolbricoham/bricohams-sdr/hardware/antenas/stl/quad_buje_70.stl

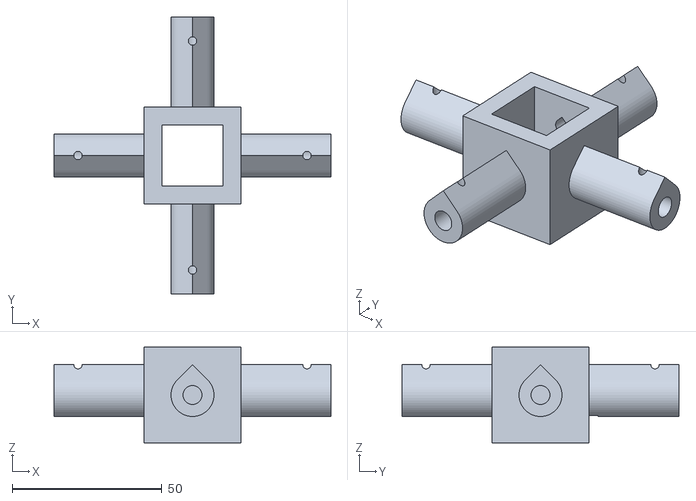
[picture p65: CAD file, 2026-10-16]
hardware/antenas/stl/quad_buje_70.stl
92.4 x 92.4 x 32.0
