anatolbricoham/bricohams-sdr/hardware/caja_v3/stl/sai_soporte_bateria.stl

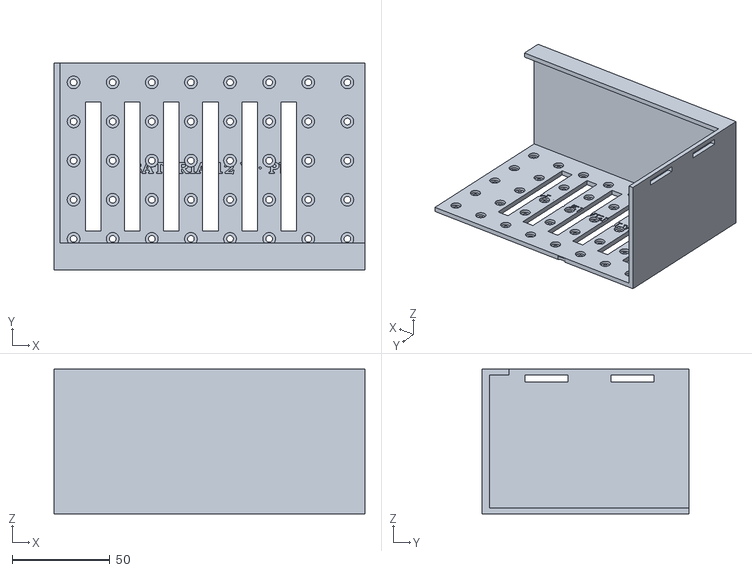
[picture p66: CAD file, 2026-10-17]
hardware/caja_v3/stl/sai_soporte_bateria.stl
159.0 x 106.0 x 74.0
