anatolbricoham/bricohams-sdr/hardware/caja_v3/stl/electronica_soporte_hub.stl

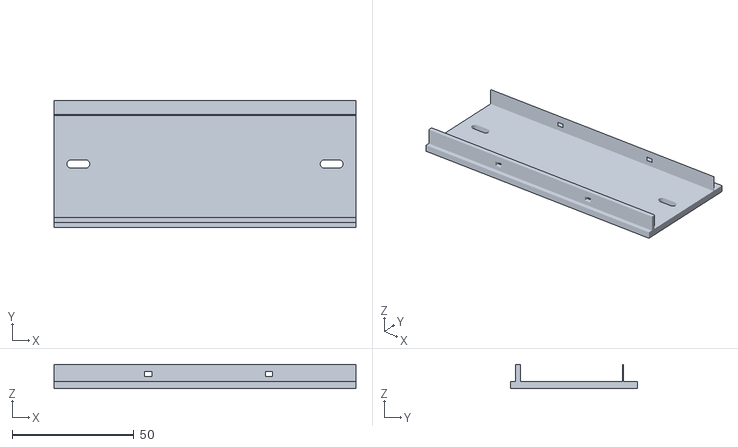
[picture p68: CAD file, 2026-10-17]
hardware/caja_v3/stl/electronica_soporte_hub.stl
124.0 x 52.0 x 10.0
