anatolbricoham/bricohams-sdr/hardware/anclajes/stl/cruceta_mastil_brazo_tapa_brazo.stl

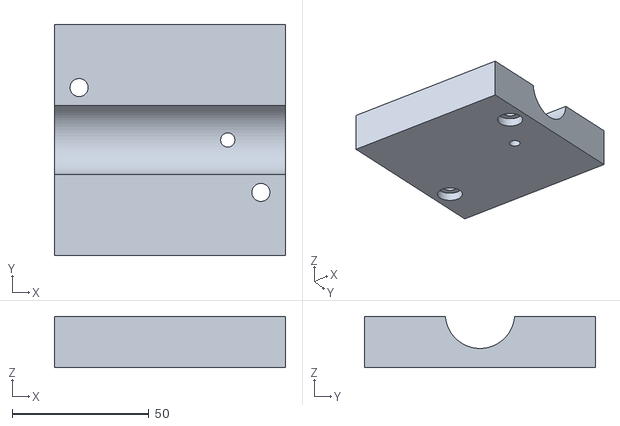
[picture p72: CAD file, 2026-10-16]
hardware/anclajes/stl/cruceta_mastil_brazo_tapa_brazo.stl
84.6 x 84.6 x 18.7
