anatolbricoham/bricohams-sdr/hardware/antenas/stl/soporte_fibra.stl

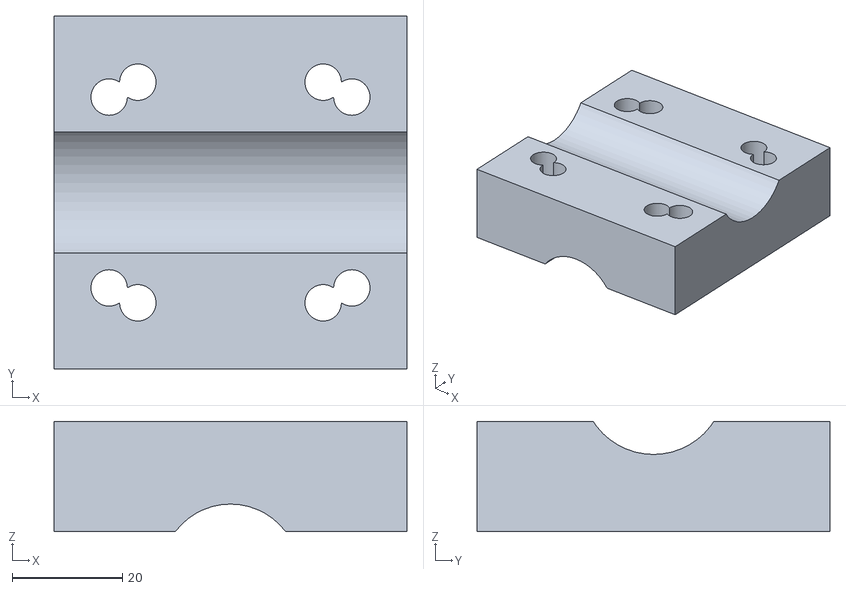
[picture p73: CAD file, 2026-10-16]
hardware/antenas/stl/soporte_fibra.stl
64.0 x 64.0 x 20.0
