anatolbricoham/bricohams-sdr/hardware/caja_v3/stl/electronica_soporte_camara.stl

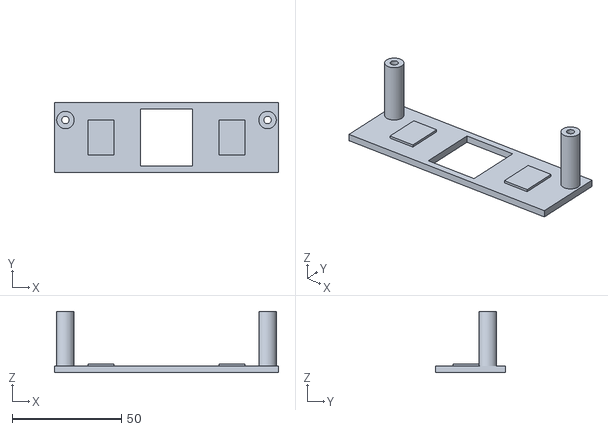
[picture p74: CAD file, 2026-10-17]
hardware/caja_v3/stl/electronica_soporte_camara.stl
102.5 x 32.0 x 28.0
