anatolbricoham/bricohams-sdr/hardware/anclajes/stl/cruceta_brazo_tubo_tapa.stl

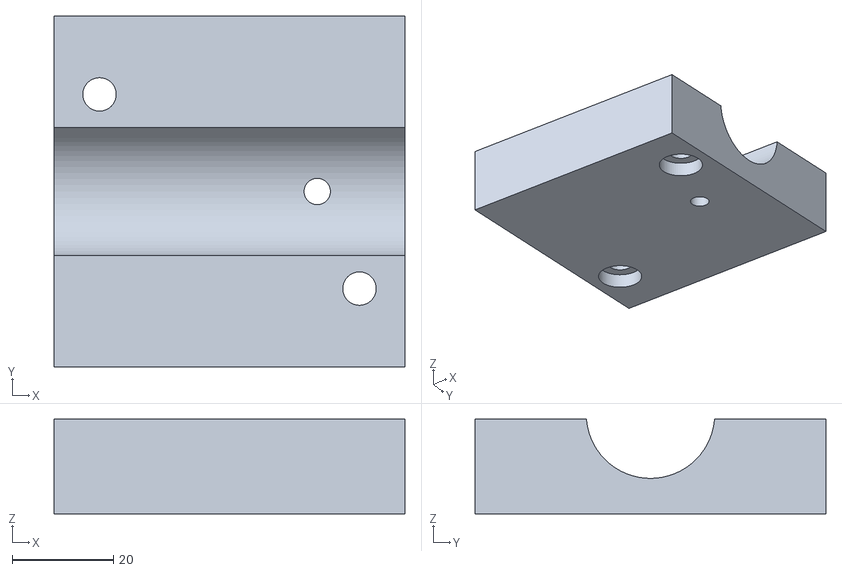
[picture p75: CAD file, 2026-10-16]
hardware/anclajes/stl/cruceta_brazo_tubo_tapa.stl
69.4 x 69.4 x 18.7
