anatolbricoham/bricohams-sdr/hardware/antenas/stl/gps_soporte.stl

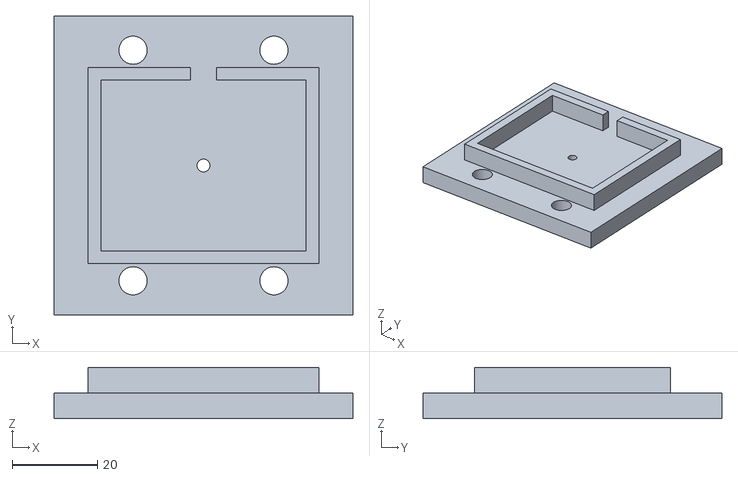
[picture p76: CAD file, 2026-10-16]
hardware/antenas/stl/gps_soporte.stl
70.0 x 70.0 x 12.0
