anatolbricoham/bricohams-sdr/hardware/caja_v3/stl/electronica_bandeja.stl

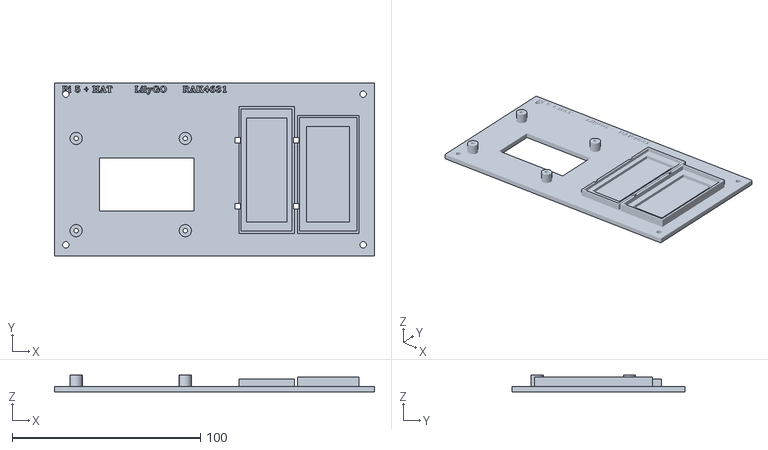
[picture p77: CAD file, 2026-10-17]
hardware/caja_v3/stl/electronica_bandeja.stl
170.0 x 92.0 x 9.00
