anatolbricoham/bricohams-sdr/hardware/caja_v3/stl/sai_tejadillo.stl

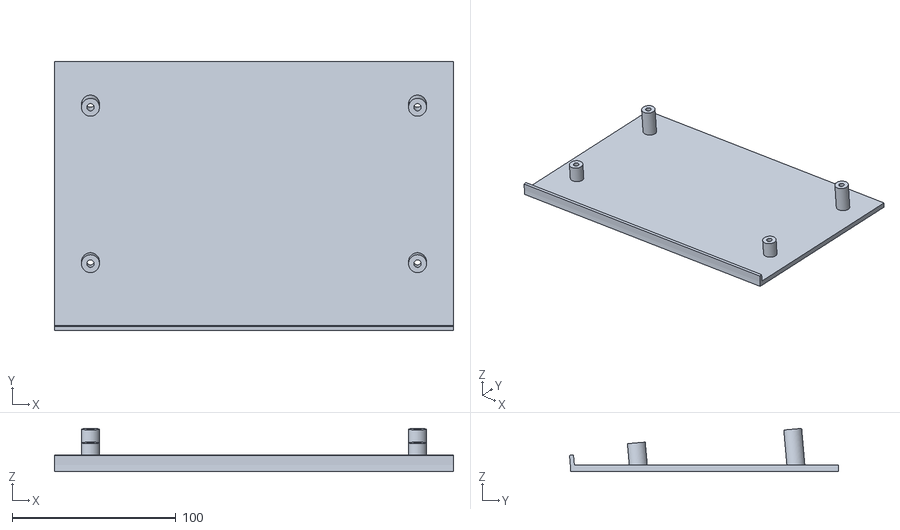
[picture p80: CAD file, 2026-10-17]
hardware/caja_v3/stl/sai_tejadillo.stl
244.0 x 164.5 x 26.4
