anatolbricoham/bricohams-sdr/hardware/anclajes/stl/pico_soporte.stl

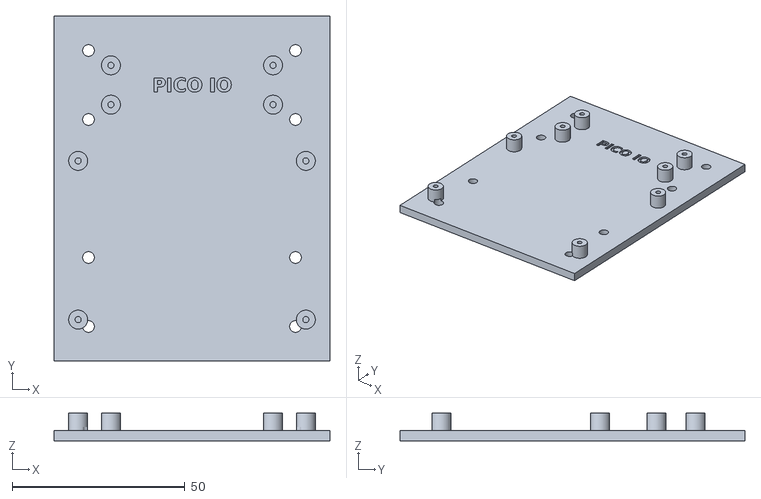
[picture p81: CAD file, 2026-10-16]
hardware/anclajes/stl/pico_soporte.stl
80.0 x 100.0 x 8.00
