anatolbricoham/bricohams-sdr/hardware/antenas/stl/discone_plantilla_disco.stl

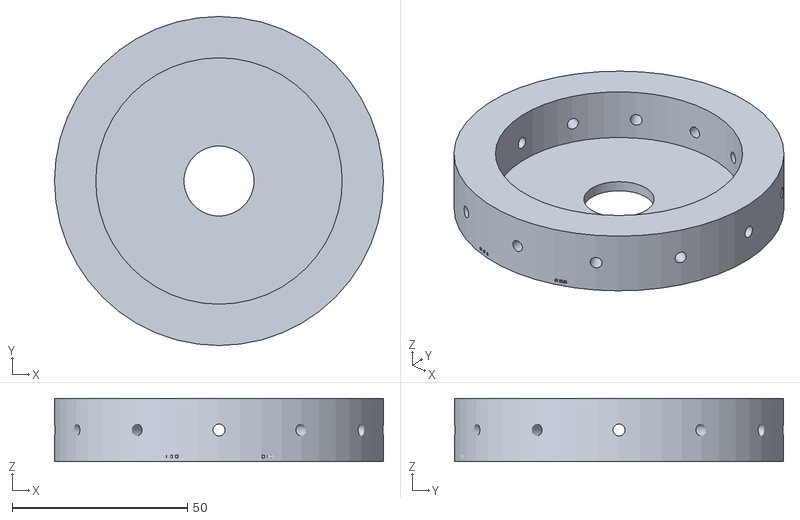
[picture p82: CAD file, 2026-10-16]
hardware/antenas/stl/discone_plantilla_disco.stl
94.0 x 94.0 x 18.0
