anatolbricoham/bricohams-sdr/hardware/antenas/stl/quad_puntera_8.stl

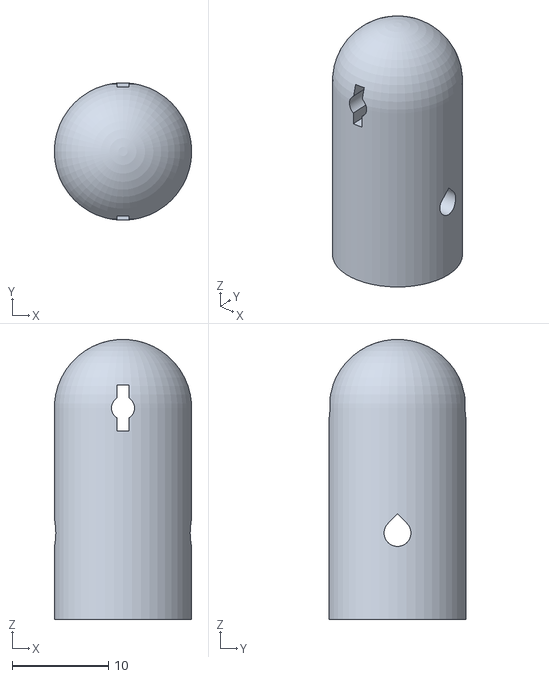
[picture p83: CAD file, 2026-10-16]
hardware/antenas/stl/quad_puntera_8.stl
14.3 x 14.3 x 29.1
