anatolbricoham/bricohams-sdr/hardware/caja_v3/stl/electronica_pletina_pared.stl

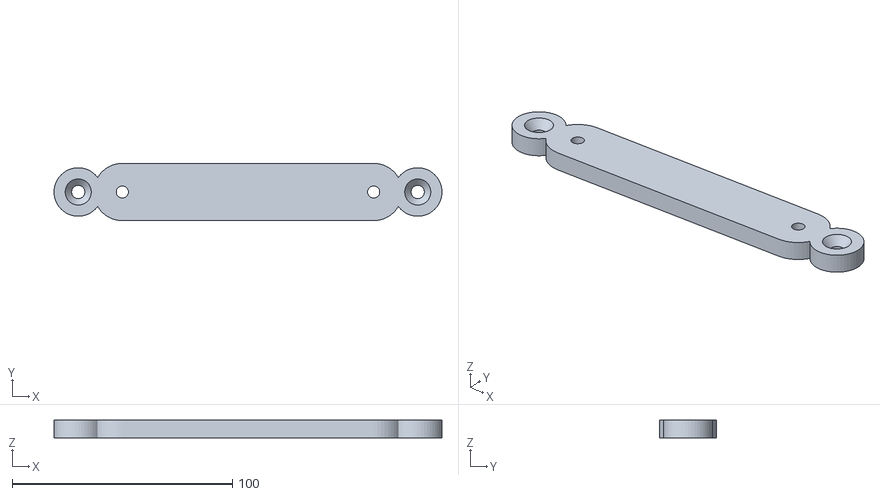
[picture p84: CAD file, 2026-10-17]
hardware/caja_v3/stl/electronica_pletina_pared.stl
176.0 x 26.0 x 8.00
