anatolbricoham/bricohams-sdr/hardware/antenas/stl/quad_puntera_6.stl

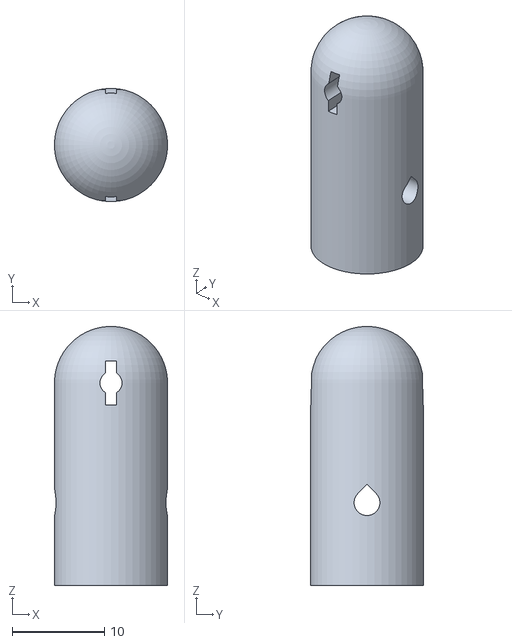
[picture p85: CAD file, 2026-10-16]
hardware/antenas/stl/quad_puntera_6.stl
12.3 x 12.3 x 28.1
