anatolbricoham/bricohams-sdr/hardware/caja_v3/stl/potencia_placa_rejilla.stl

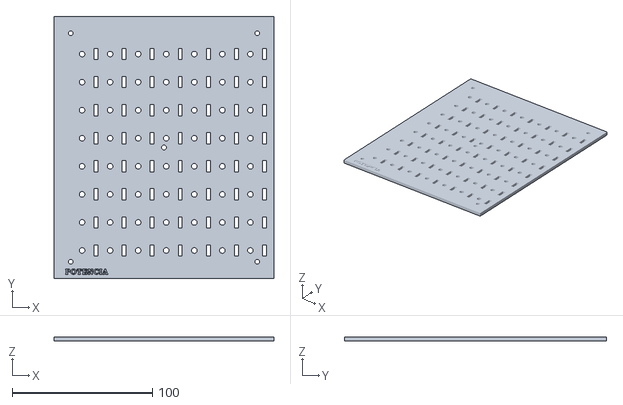
[picture p87: CAD file, 2026-10-17]
hardware/caja_v3/stl/potencia_placa_rejilla.stl
156.8 x 186.8 x 3.20
