anatolbricoham/bricohams-sdr/hardware/antenas/stl/mla_caja_base.stl

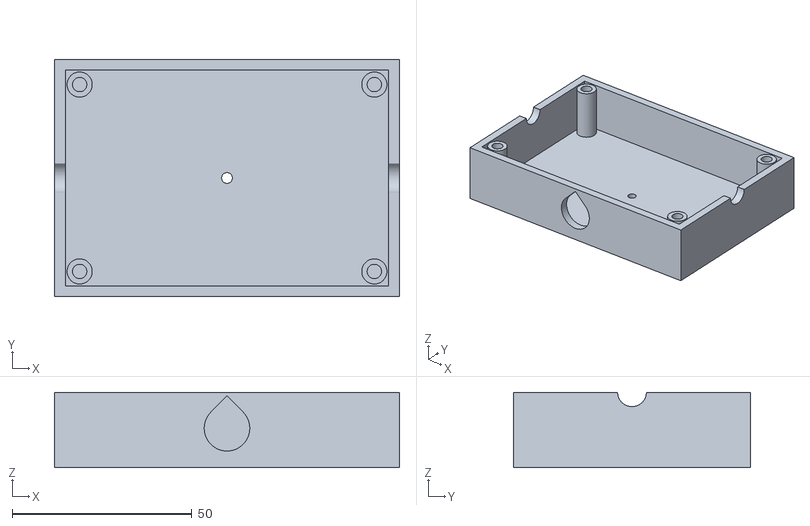
[picture p88: CAD file, 2026-10-16]
hardware/antenas/stl/mla_caja_base.stl
96.0 x 66.0 x 21.0
