anatolbricoham/bricohams-sdr/hardware/caja_v3/stl/sai_pletina_trafo.stl

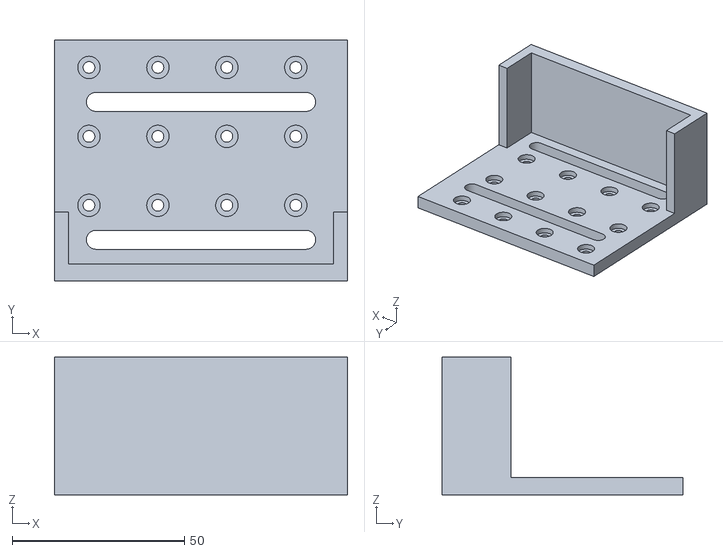
[picture p89: CAD file, 2026-10-17]
hardware/caja_v3/stl/sai_pletina_trafo.stl
85.0 x 70.0 x 40.0
