anatolbricoham/bricohams-sdr/hardware/antenas/stl/quad_alim_2m.stl

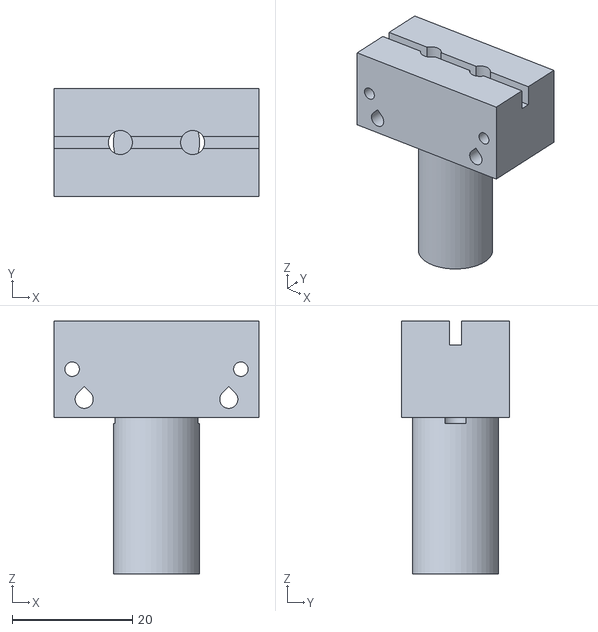
[picture p90: CAD file, 2026-10-16]
hardware/antenas/stl/quad_alim_2m.stl
34.0 x 18.0 x 42.0
