anatolbricoham/bricohams-sdr/hardware/caja_v3/stl/sai_guia_pcb.stl

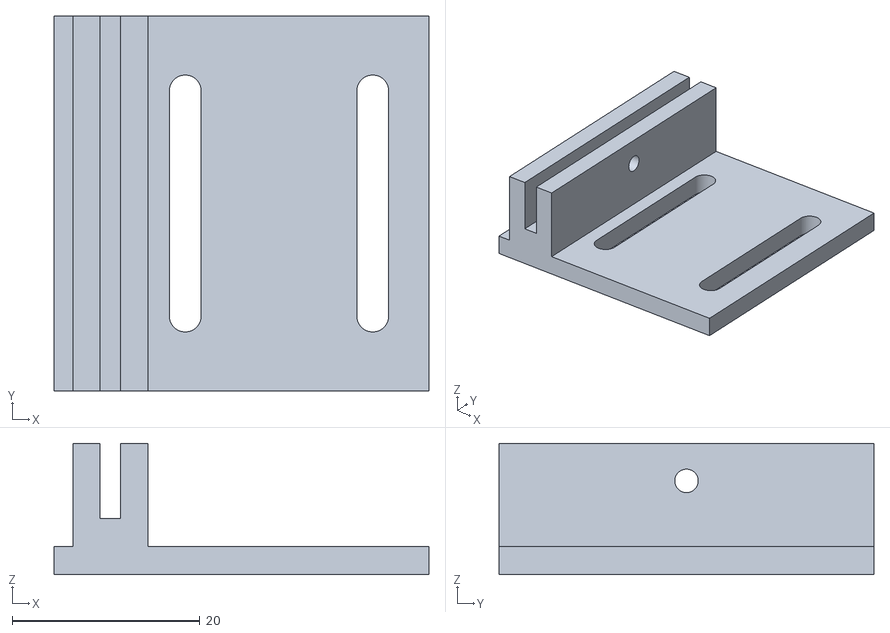
[picture p91: CAD file, 2026-10-17]
hardware/caja_v3/stl/sai_guia_pcb.stl
40.0 x 40.0 x 14.0
