anatolbricoham/bricohams-sdr/hardware/caja_v3/stl/electronica_poste_superior.stl

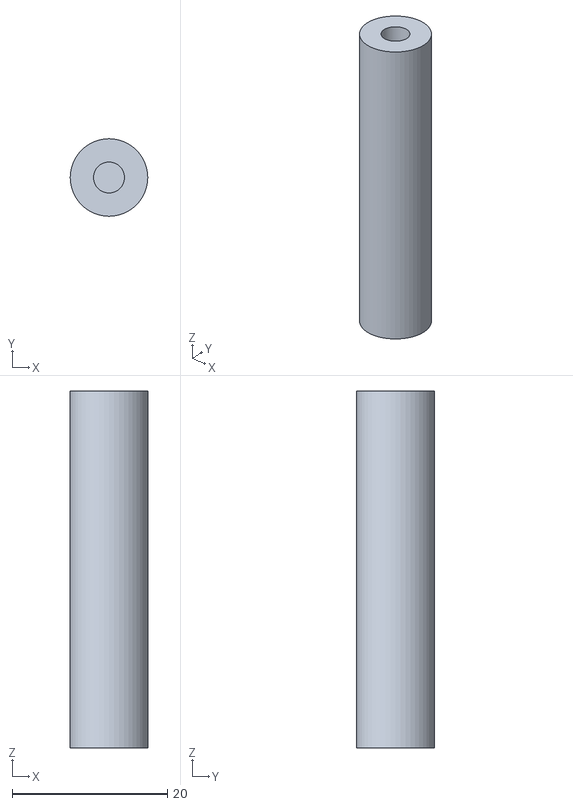
[picture p93: CAD file, 2026-10-17]
hardware/caja_v3/stl/electronica_poste_superior.stl
10.0 x 10.0 x 46.0
