anatolbricoham/bricohams-sdr/hardware/antenas/stl/funda_sma.stl

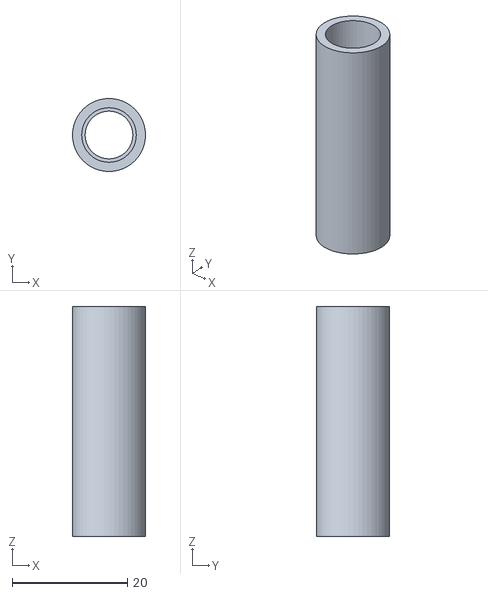
[picture p94: CAD file, 2026-10-16]
hardware/antenas/stl/funda_sma.stl
12.7 x 12.7 x 40.0
