anatolbricoham/bricohams-sdr/hardware/caja_v3/stl/electronica_poste_medio.stl

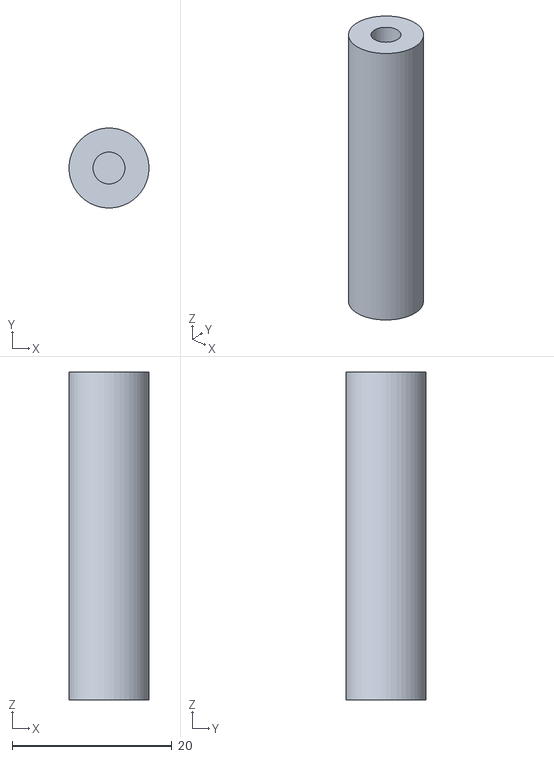
[picture p95: CAD file, 2026-10-17]
hardware/caja_v3/stl/electronica_poste_medio.stl
10.0 x 10.0 x 41.0
