anatolbricoham/bricohams-sdr/hardware/caja_v3/stl/electronica_poste_bandeja.stl

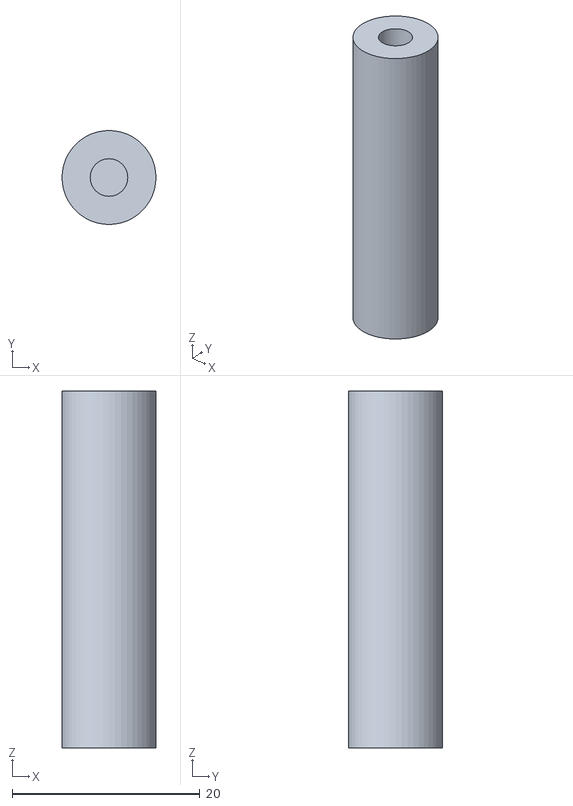
[picture p97: CAD file, 2026-10-17]
hardware/caja_v3/stl/electronica_poste_bandeja.stl
10.0 x 10.0 x 38.0
