anatolbricoham/bricohams-sdr/hardware/antenas/stl/tapon_varilla.stl

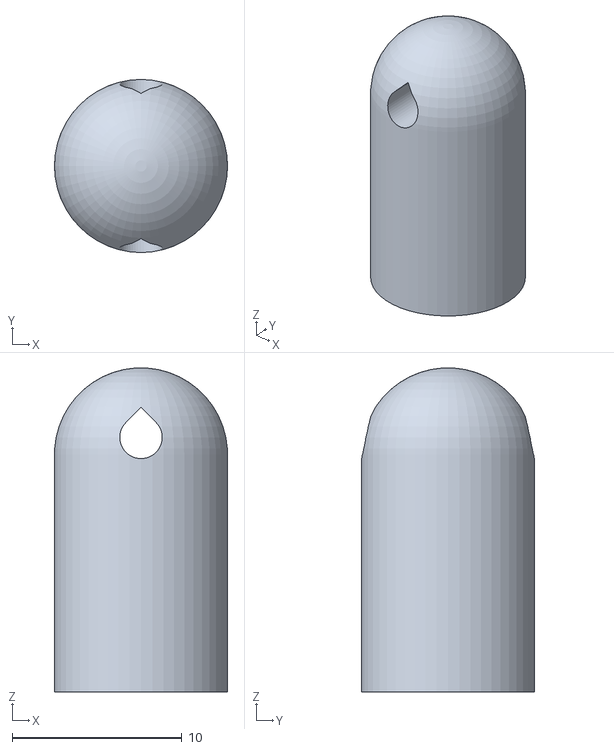
[picture p98: CAD file, 2026-10-16]
hardware/antenas/stl/tapon_varilla.stl
10.2 x 10.2 x 19.1
