anatolbricoham/bricohams-sdr/hardware/antenas/stl/mla_clip_lazo.stl

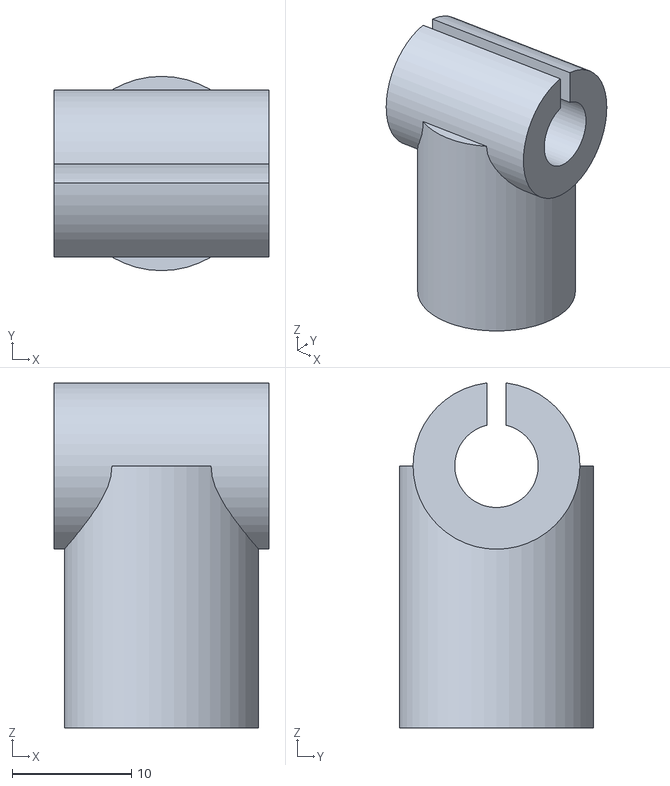
[picture p102: CAD file, 2026-10-16]
hardware/antenas/stl/mla_clip_lazo.stl
18.0 x 16.3 x 28.9
