anatolbricoham/bricohams-sdr/hardware/caja_v3/stl/potencia_brida_cargador.stl

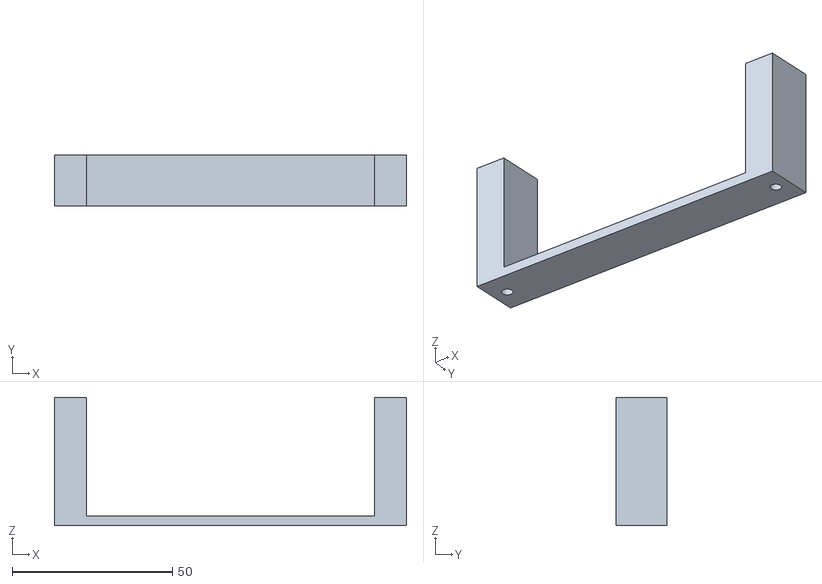
[picture p103: CAD file, 2026-10-17]
hardware/caja_v3/stl/potencia_brida_cargador.stl
110.0 x 16.0 x 40.0
