anatolbricoham/bricohams-sdr/hardware/antenas/stl/brazo_mastil.stl

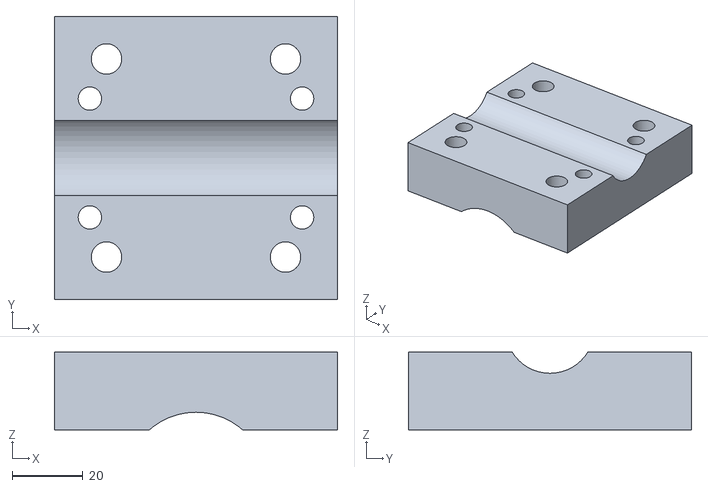
[picture p106: CAD file, 2026-10-16]
hardware/antenas/stl/brazo_mastil.stl
80.0 x 80.0 x 22.0
