anatolbricoham/bricohams-sdr/hardware/caja_v3/stl/electronica_soporte_sdrplay.stl

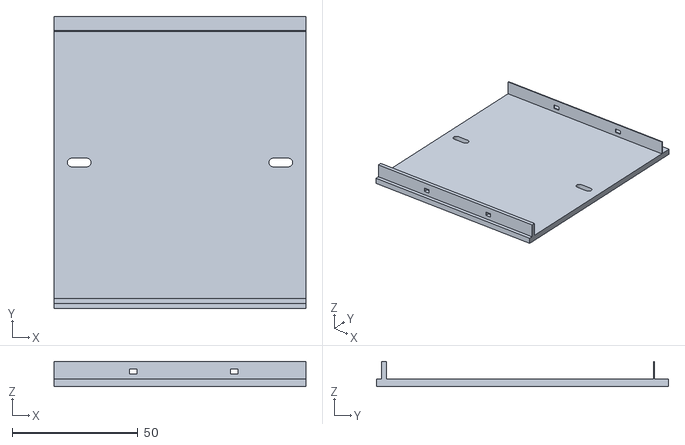
[picture p107: CAD file, 2026-10-17]
hardware/caja_v3/stl/electronica_soporte_sdrplay.stl
100.0 x 116.0 x 10.0
