anatolbricoham/bricohams-sdr/hardware/caja_v3/stl/sai_soporte_wago.stl

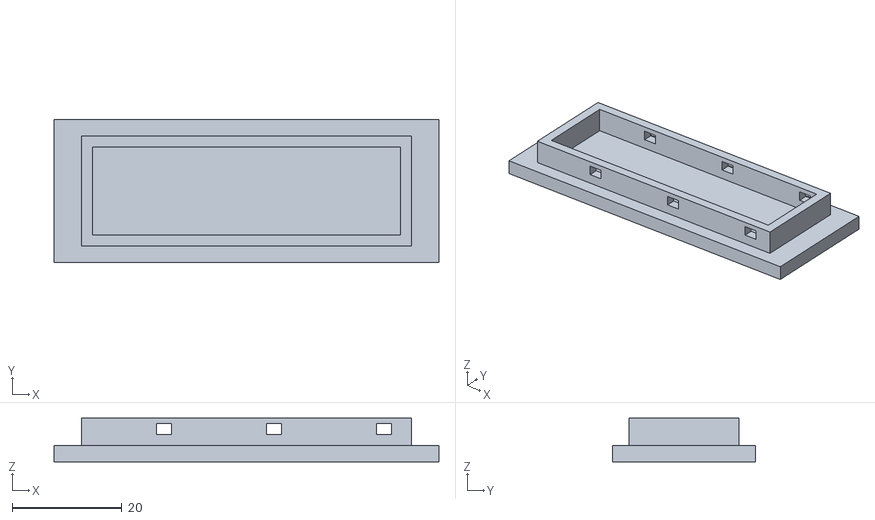
[picture p108: CAD file, 2026-10-17]
hardware/caja_v3/stl/sai_soporte_wago.stl
70.0 x 26.0 x 8.00
