anatolbricoham/bricohams-sdr/hardware/caja_v3/stl/electronica_bandeja_sdr.stl

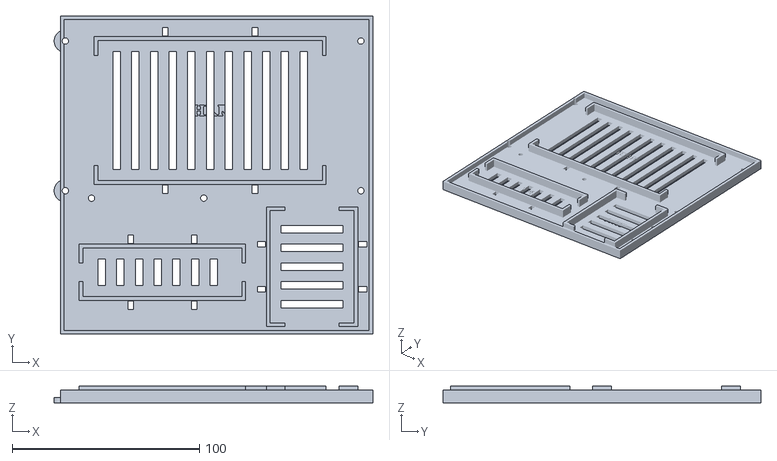
[picture p110: CAD file, 2026-10-17]
hardware/caja_v3/stl/electronica_bandeja_sdr.stl
170.4 x 170.0 x 8.99
