anatolbricoham/bricohams-sdr/hardware/caja_v3/stl/electronica_visera.stl

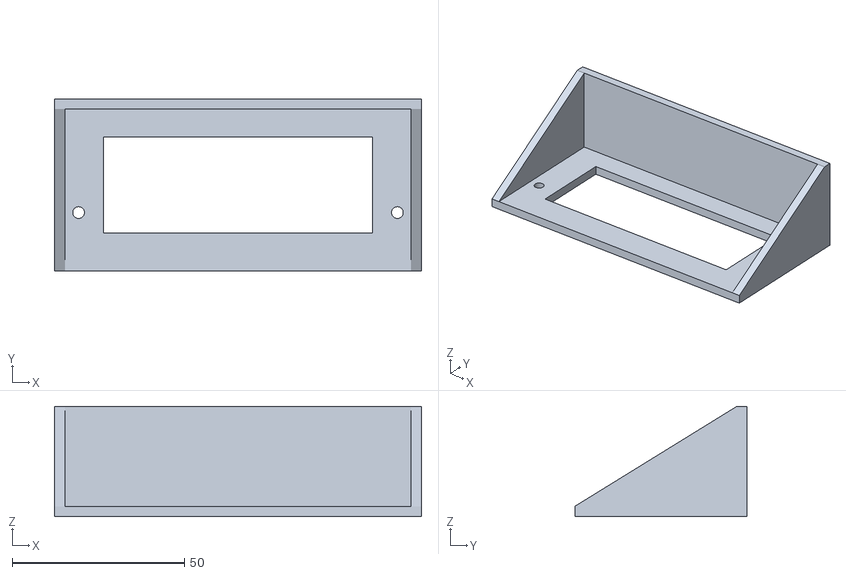
[picture p111: CAD file, 2026-10-17]
hardware/caja_v3/stl/electronica_visera.stl
106.5 x 50.0 x 32.0
