anatolbricoham/bricohams-sdr/hardware/caja_v3/stl/potencia_cuerpo.stl

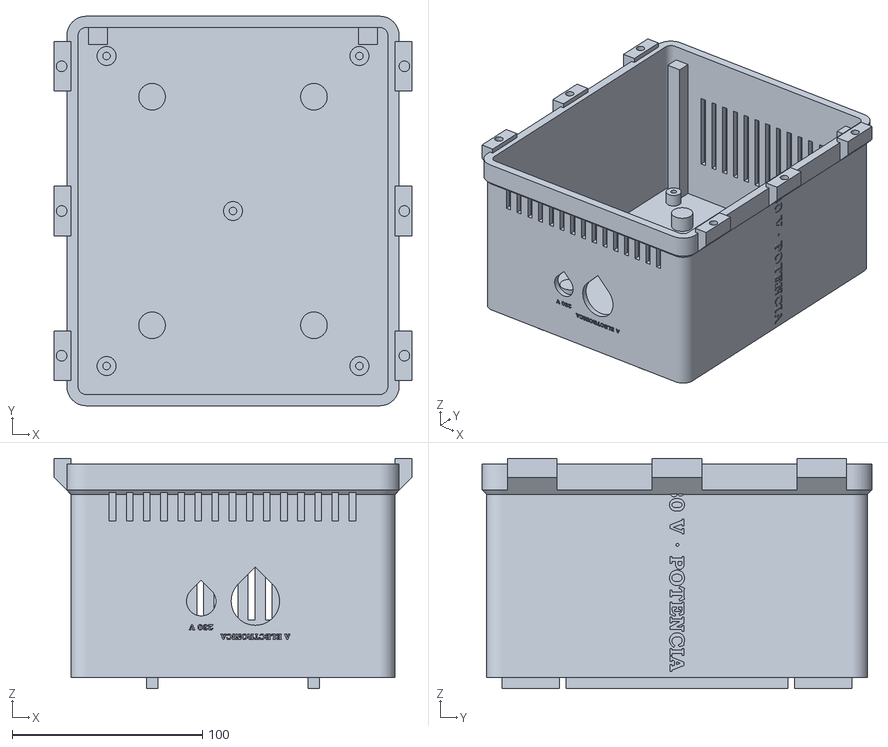
[picture p113: CAD file, 2026-10-17]
hardware/caja_v3/stl/potencia_cuerpo.stl
188.0 x 204.6 x 121.0
