anatolbricoham/bricohams-sdr/hardware/caja_v3/stl/electronica_tapon_n.stl

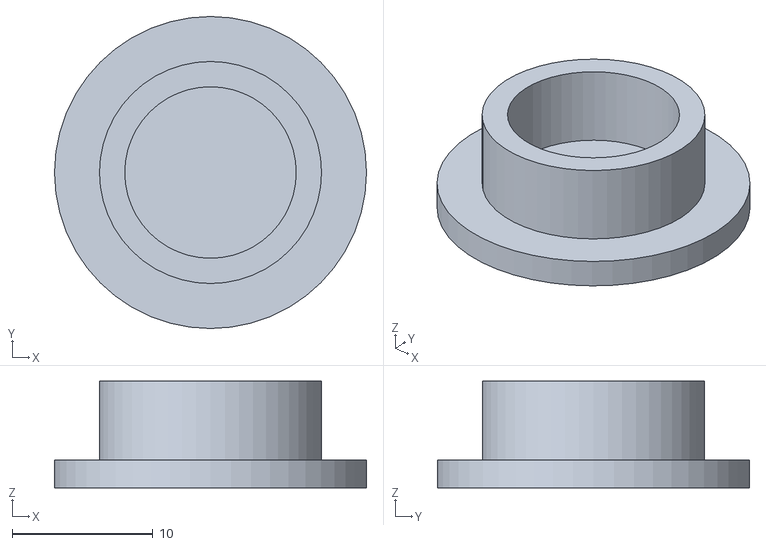
[picture p114: CAD file, 2026-10-17]
hardware/caja_v3/stl/electronica_tapon_n.stl
22.2 x 22.2 x 7.60
