anatolbricoham/bricohams-sdr/hardware/caja_v3/stl/potencia_tapa.stl

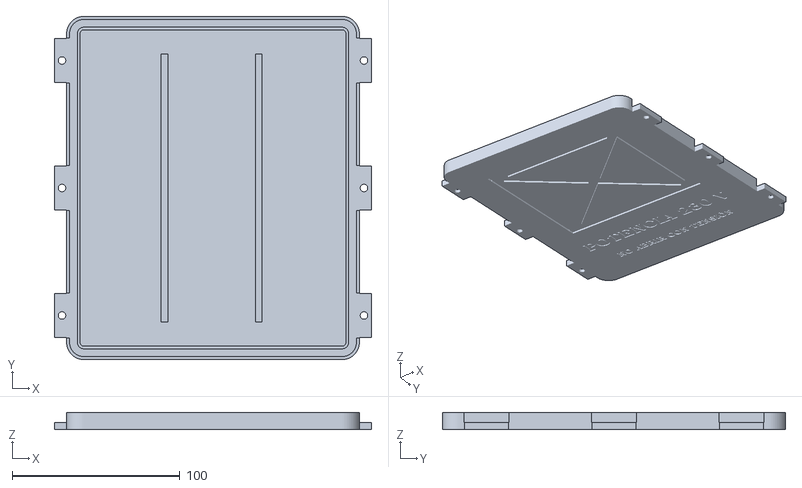
[picture p116: CAD file, 2026-10-17]
hardware/caja_v3/stl/potencia_tapa.stl
189.0 x 204.6 x 10.4
