anatolbricoham/bricohams-sdr/hardware/caja_v3/stl/sai_soporte_filtro.stl

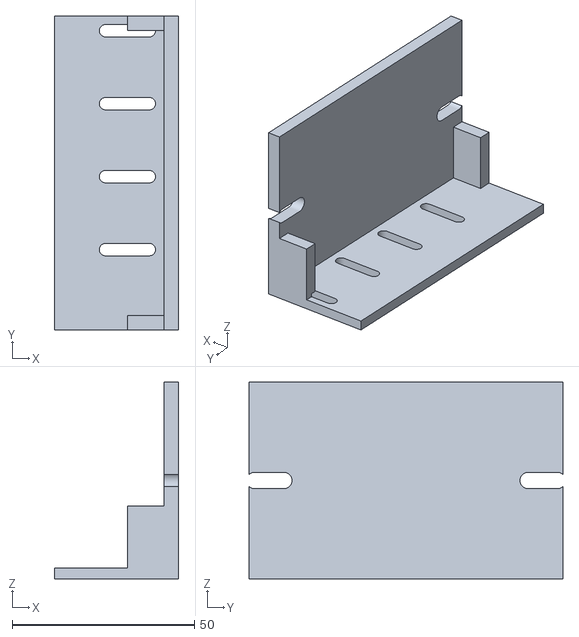
[picture p117: CAD file, 2026-10-17]
hardware/caja_v3/stl/sai_soporte_filtro.stl
34.0 x 86.0 x 54.0
