anatolbricoham/bricohams-sdr/hardware/caja_v3/stl/sai_cuerpo.stl

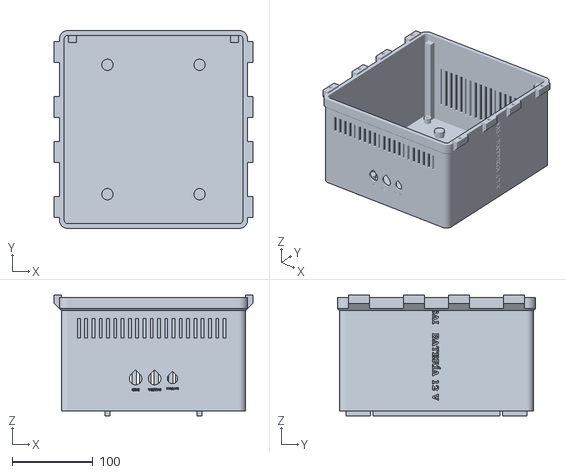
[picture p118: CAD file, 2026-10-17]
hardware/caja_v3/stl/sai_cuerpo.stl
246.0 x 244.6 x 149.0
