anatolbricoham/bricohams-sdr/hardware/caja_v3/stl/potencia_soporte_mastil.stl

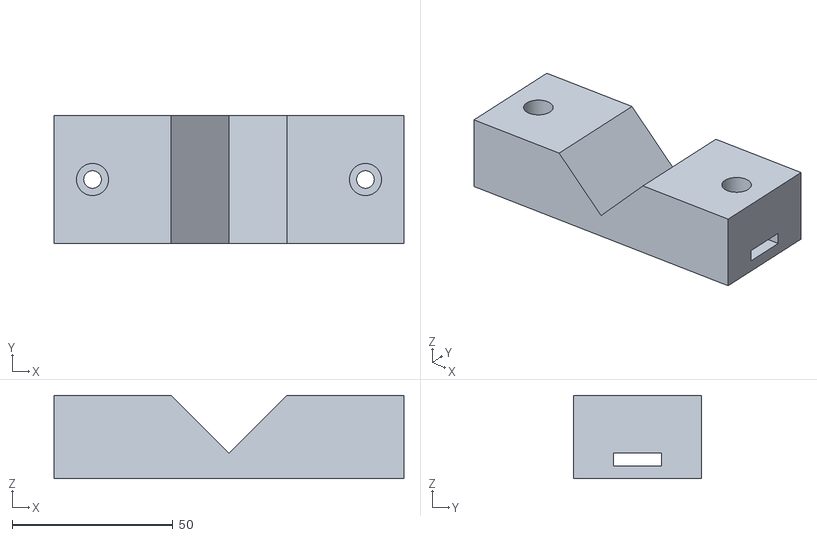
[picture p119: CAD file, 2026-10-17]
hardware/caja_v3/stl/potencia_soporte_mastil.stl
109.0 x 40.0 x 26.0
