anatolbricoham/bricohams-sdr/hardware/caja_v3/stl/electronica_rejilla_ventilador.stl

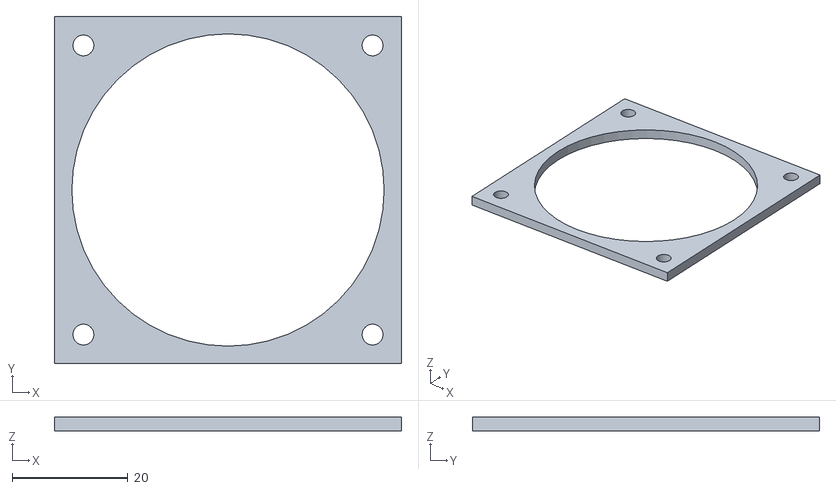
[picture p120: CAD file, 2026-10-17]
hardware/caja_v3/stl/electronica_rejilla_ventilador.stl
60.0 x 60.0 x 2.40
