anatolbricoham/bricohams-sdr/hardware/caja_v3/stl/potencia_tejadillo.stl

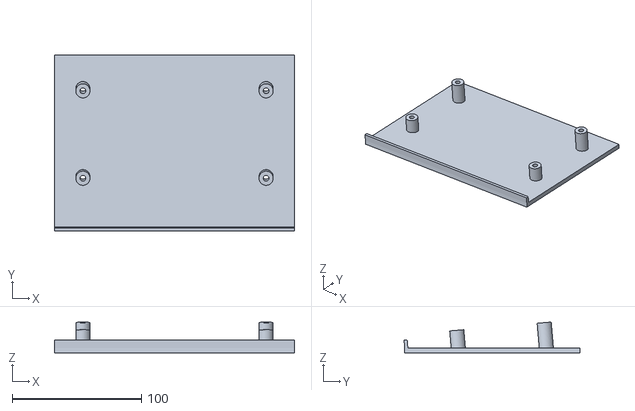
[picture p121: CAD file, 2026-10-17]
hardware/caja_v3/stl/potencia_tejadillo.stl
186.0 x 136.4 x 24.0
