anatolbricoham/bricohams-sdr/(list of files, cad)

Other CAD files:
hardware/anclajes/stl/cruceta_brazo_fibra_tapa_fibra.stl
hardware/anclajes/stl/cruceta_mastil_quad_tapa_mastil.stl
hardware/caja_v3/stl/sai_tapa.stl
hardware/caja_v3/stl/electronica_placa_rejilla.stl
hardware/anclajes/anclajes_bricohams.scad
hardware/antenas/antenas_bricohams.scad
hardware/caja_v3/caja_v3.scad
hardware/caja/caja_bricohams.scad
hardware/caja/stl/cuerpo.stl
hardware/caja/stl/garita_base.stl
hardware/caja/stl/garita_plato.stl
hardware/caja/stl/garita_tapa.stl
hardware/caja/stl/junta_tapa.stl
hardware/caja/stl/junta_ventana.stl
hardware/caja/stl/pasamuros_usb.stl
hardware/caja/stl/placa_electronica.stl
hardware/caja/stl/placa_potencia.stl
hardware/caja/stl/separador_ir.stl
hardware/caja/stl/soporte_camara.stl
hardware/caja/stl/soporte_mastil.stl
hardware/caja/stl/tapa.stl
hardware/caja/stl/tapa_potencia.stl
hardware/caja/stl/tejadillo.stl
hardware/caja/stl/visera.stl
