anatolbricoham/bricohams-sdr/hardware/anclajes/render/montaje.png

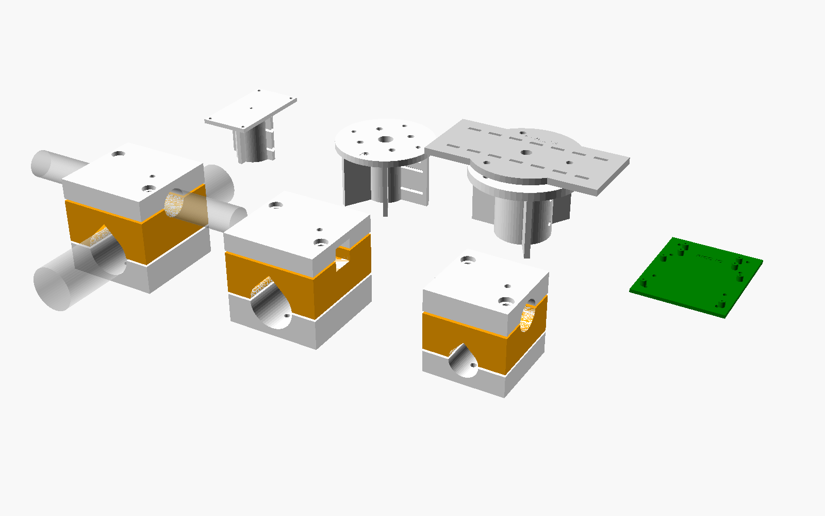
hardware/anclajes/render/montaje.png
