anatolbricoham/bricohams-sdr/tests/datos/owrx-1.2.126/htdocs_index.html

${header}







 

Timeslot 1

 

Timeslot 2

 

 

OpenWebRX+ message log

Author: Marat Fayzullin (http://fms.komkon.org/) | OpenWebRX+ documentation (https://fms.komkon.org/OWRX) and support (https://groups.io/g/openwebrx)

Send

▾ Modes

▾ Controls

▴ Settings

Draw white frame around panels

Hold mouse wheel down to tune

Show pointer frequency

Show band plan ribbon

▾ Display

REC

00:00 UTC

0 dB

This receiver is currently unavailable due to technical issues.

Error Message:

Start OpenWebRX+

## Edit Bookmark

Name:

Frequency:

Modulation:

Underlying:

Description:

Scannable

Cancel

Save

## Search Bookmarks

Close

Search
