anatolbricoham/bricohams-sdr/files/htdocs/plugins/receiver/tune_precise/tune_precise.jpg

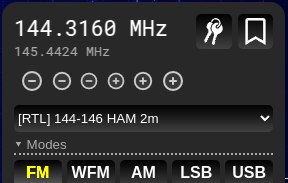
files/htdocs/plugins/receiver/tune_precise/tune_precise.jpg
