anatolbricoham/bricohams-sdr/hardware/antenas/sim/resultados/discone.png

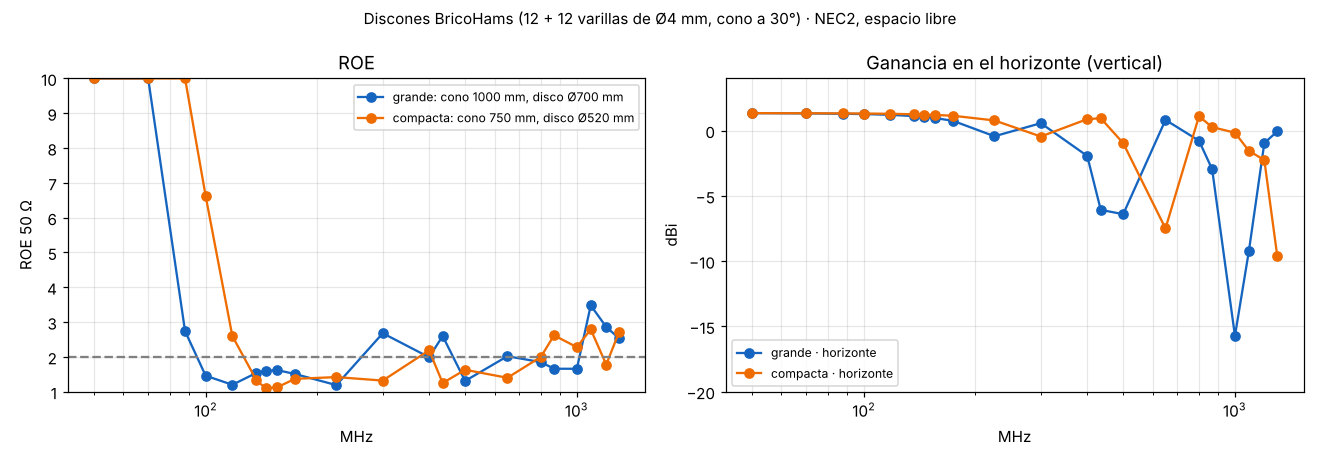
hardware/antenas/sim/resultados/discone.png
