anatolbricoham/bricohams-sdr/files/htdocs/plugins/receiver/antenna_switcher/antenna_switcher.py

# Simple Flask backend to work with the JavaScript frontend for the antenna switcher by DL9UL
# License: Apache 2
# Copyright (c) 2024 Dimitar Milkov, LZ2DMV

# pip install flask flask-cors RPi.GPIO

from flask import Flask, request, jsonify
from flask_cors import CORS
import RPi.GPIO as GPIO
import os

config_file = 'antenna_switcher.cfg'
antenna_file = 'ant'

def load_config():
    config = {}
    if os.path.exists(config_file):
        with open(config_file, 'r') as file:
            for line in file:
                name, value = line.strip().split('=')
                if name == 'antenna_pins':
                    config[name] = eval(value)
    return config

config = load_config()
antenna_pins = config.get('antenna_pins')

if antenna_pins is None:
    raise ValueError("Configuration file is missing required values.")

num_antennas = len(antenna_pins)

app = Flask(__name__)
CORS(app)
GPIO.setmode(GPIO.BCM)

for pin in antenna_pins:
    GPIO.setup(pin, GPIO.OUT)

def read_active_antenna():
    if os.path.exists(antenna_file):
        with open(antenna_file, 'r') as file:
            return file.read().strip()
    return None

def write_active_antenna(value):
    with open(antenna_file, 'w') as file:
        file.write(value)

def set_gpio_for_antenna(antenna_id):
    for i, pin in enumerate(antenna_pins):
        GPIO.output(pin, GPIO.HIGH if i == antenna_id else GPIO.LOW)

def initialize_antenna():
    active_antenna = read_active_antenna()
    if active_antenna and active_antenna.isdigit() and 1 <= int(active_antenna) <= num_antennas:
        set_gpio_for_antenna(int(active_antenna) - 1)
    else:
        set_gpio_for_antenna(0)
        write_active_antenna('1')

@app.route('/antenna_switch', methods=['POST'])
def antennaswitch():
    data = request.get_json()
    command = data.get('command')

    if command.isdigit() and 1 <= int(command) <= num_antennas:
        return set_antenna(command)
    elif command == 's':
        return get_active_antenna()
    elif command == 'n':
        return get_antenna_count()
    else:
        return jsonify({'error': 'Invalid command'}), 400

def get_active_antenna():
    active_antenna = read_active_antenna()
    if active_antenna is None:
        return jsonify(payload={'response': '0'})
    return jsonify(payload={'response': active_antenna})

def get_antenna_count():
    return jsonify(payload={'response': f'n:{num_antennas}'})

def set_antenna(antenna_id):
    active_antenna = read_active_antenna()
    if active_antenna == antenna_id:
        return jsonify(payload={'response': antenna_id})

    try:
        set_gpio_for_antenna(int(antenna_id) - 1)
        write_active_antenna(antenna_id)
        return jsonify(payload={'response': antenna_id})
    except Exception as e:
        print(f"Error: {e}")
        return jsonify(payload={'response': '0'}), 500

if __name__ == '__main__':
    try:
        initialize_antenna()
        app.run(host='127.0.0.1', port=8075)
    finally:
        GPIO.cleanup()
