anatolbricoham/bricohams-sdr/firmware/rak4631-lora-aprs/rak4631-lora-aprs.ino

// BricoHams RAK4631 LoRa APRS (port de LoRa APRS iGate de CA2RXU a WisBlock RAK4631).
// El código está en bricohams_rak_aprs.cpp y en los *_utils.cpp de esta carpeta.
// Compilar: tools/compilar_rak.sh  ·  Grabar: sudo bricohams-lilygo rak-grabar  (manual 35)
#include <Adafruit_TinyUSB.h>
