anatolbricoham/bricohams-sdr/(commit log)

2026-10-12 v5.1: interfaz web APRS y Meshtastic 433, firmware RAK 1.0.1, GitHub sin datos personales
    - Panel /settings/bricohams/aprs: mensajes APRS con acuse, baliza a demanda,
    estaciones oídas, digipeater automático (RAK_DIGI="auto"), bootloader y
    puesta en marcha; API local 127.0.0.1:8077 en bricohams-rak-aprs (Pasarela).
    - bricohams-mesh-puente: único dueño del USB del LilyGO 433 (TCP 4404 + HTTP
    4480) y cliente web oficial de Meshtastic en :8444 solo para el admin.
    - Firmware RAK 1.0.1 (sin nan en el JSON) + VERSION.json; órdenes bootloader,
    gps y puesta-en-marcha.
    - Repositorio despersonalizado; tools/datos_personales.py (huellas SHA-256) y
    tools/git_sanear.sh; .gitignore restaurad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
    [configuration.h]
2026-10-17 v5.4.0: alinear distribucion publica con la linea privada
    Publicacion anonimizada con chat Meshtastic, Telegram, clima, WSPR, satelites y correcciones visuales. Conserva el historial publico y sus recursos exclusivos sin incorporar commits privados.
    [caja_v3.scad, electronica_bandeja.stl, electronica_bandeja_sdr.stl, electronica_capota.stl, electronica_cuerpo.stl, electronica_junta_tapa.stl, electronica_placa_rejilla.stl, electronica_pletina_pared.stl]
2026-10-17 docs: limpiar referencias de herramientas en la distribucion publica
2026-10-17 docs y funciones: agendas, avisos, filtros de satelites y esquemas v5.4
2026-10-17 hardware: redisenar cajas v3 y preparar SDR futuros y potencia
    Regenera STL y vistas, incorpora bandeja SDR adicional y cuna RAK, y documenta la reserva de potencia y configuracion futura.
    [caja_v3.scad, electronica_bandeja.stl, electronica_bandeja_sdr.stl, electronica_bandeja_sdr2.stl, electronica_capota.stl, electronica_cuerpo.stl, electronica_junta_tapa.stl, electronica_placa_rejilla.stl]
2026-10-17 docs: anadir guias Kobra S1 ASA y laboratorio RF NanoVNA
    Incluye calibracion y mantenimiento de impresora, procedimientos RF, hojas CSV de trazabilidad y cualificacion, ilustraciones y capturas de referencia.
    [01_componentes.csv, 02_instrumentos.csv, 03_requisitos.csv, 04_calibraciones.csv, 05_medidas_rf.csv, 06_medidas_sdr_aux.csv, 07_incertidumbre.csv, 08_decisiones.csv]
2026-10-17 chore(license): adopt BricoHams licensing scheme
    Software: MIT. Hardware design files (PCB, fabrication): CERN-OHL-S-2.0.
    3D models, CAD and documentation: CC BY-SA 4.0. Third-party credits and
    components keep their own terms.
