anatolbricoham/bricohams-sdr/(notices)

Notices in the files:
firmware/rak4631-lora-aprs/kiss_protocol.h:
LoRa APRS iGate is free software: you can redistribute it and/or modify
it under the terms of the GNU General Public License as published by
the Free Software Foundation, either version 3 of the License, or
(at your option) any later version.
tests/datos/owrx-1.2.126/htdocs_index.html:
Copyright (c) 2013-2015 by Andras Retzler <randras@sdr.hu>
Copyright (c) 2019-2024 by Jakob Ketterl <dd5jfk@darc.de>
Copyright (c) 2022-2026 by Marat Fayzullin <luarvique@gmail.com>
This program is free software: you can redistribute it and/or modify
it under the terms of the GNU Affero General Public License as
published by the Free Software Foundation, either version 3 of the
License, or (at your option) any later version.
